bontango/SternFA/bin/changelog.txt

--	V x.02 with adapted boot_message
--	V x.03 corrections: inverted sound output (74HCT240) & internal signals, cpu clock adjusted to 833KHz
--	V x.04 added CRC check, clock speed 446KHz/892KHz, MPU200 games now in range 0..63
--
-- Everything below this line is written by scripts\release.ps1. The leading digit of
-- the version is the BOARD (1 = HW 1.0, 3 = HW 1.1 Cyclone IV, 4 = HW 1.1 Cyclone 10,
-- 5 = HW 2.0), the two sub digits are the software version from
-- rtl\common\version_pkg.vhd and move for all boards at once.

2026-09-08 15:58  version .0.5
  SW .0.5 - CPU-Takt jetzt auf ALLEN Boards 446/893 kHz. rtl\cyclone_IV\cpu_clock_gen.vhd teilte bis .0.4 haendisch 100/60 (500/833 kHz) statt 112/56; der Changelog zu x.04 nennt seit jeher 446/892 kHz, und 3,579545 MHz (Original-Stern-Quarz) / 8 bzw. / 4 ergibt 447/895 kHz - die Cyclone-10-Werte waren die richtigen, der Cyclone-IV-PLL war schlicht nie neu erzeugt worden. BETROFFEN SIND hw1_0_cyclone_IV, hw1_1_cyclone_IV UND hw2_0_dev_open; hw1_1_cyclone_10 aendert sich nicht und ist die Referenz, wie sich die anderen jetzt verhalten muessen. Beim ersten Test auf Spielgeschwindigkeit, Sound-Timing und Display-Multiplex achten - faellt etwas auf, zurueck auf SternFA_304.jic bzw. SternFA_103.jic. Ausserdem: R5101.vhd zwischen den beiden Chipfamilien vereinheitlicht (NEW_DATA_WITH_NBE_READ -> NEW_DATA_NO_NBE_READ; ohne Wirkung, width_byteena=1 und kein byteena-Port, Zahlen unveraendert), damit sich die vier Megafunction-Wrapper jetzt in nichts ausser dem Family-String unterscheiden. ERSTES RELEASE AUS DEM GEMEINSAMEN SOURCEBAUM (Umbau 08.09.2026) und ERSTES RELEASE UEBERHAUPT FUER HW 2.0 - SternFA_505.jic ist ein Prototyp-Bitstream, das Board ist nie gelaufen und FA-Control ist nie an einer Maschine gewesen. KEINE der vier Varianten ist an Hardware getestet.
  hw1_0_cyclone_IV     1.0.5    SternFA_105.jic  sha256:866FD8AB3FF3F034
  hw1_1_cyclone_10     4.0.5    SternFA_405.jic  sha256:10F4D41DD3CEE834
  hw1_1_cyclone_IV     3.0.5    SternFA_305.jic  sha256:C6C457F4412DCBF7
  hw2_0_dev_open       5.0.5    SternFA_505.jic  sha256:3359C038ADE97E95

2026-09-19 11:27  version .0.6
  SW .0.6 - nur HW 2.0: Spiel-ROM vom ESP32 statt von der SD-Karte. rtl\fa_control\esp_rom_loader.vhd fragt nach dem DIP-Lesen bis zu 3 s beim ESP32-Modul (FA-Control ab 1.21, Menue 08 GAME ROMS) nach dem gewaehlten Spiel; liegt es dort, kommen 8 KB + CRC16 ueber die UART, die SD-Karte wird nicht gelesen, Statusziffer 3. Sonst wie bisher von SD. FA-Control meldet bei Opcode 8 jetzt die volle dreistellige Spielnummer (vorher nur die Einerstelle). Fuer HW 1.0/1.1 aendert .0.6 nichts, daher kein 106/306/406. AM SCHREIBTISCH GETESTET (19.09.2026), IM AUTOMATEN NOCH NICHT. PCB v2.00 braucht weiterhin die zwei nachgeruesteten Pull-ups an GS_Dips/Opt_Dips, sonst liest sie keinen DIP. Faellt im Geraet etwas auf: zurueck auf SternFA_505.jic.
  hw2_0_dev_open       5.0.6    SternFA_506.jic  sha256:4117A4C47BCBAF2C

2026-09-19 11:48  version .0.6
  SW .0.6 (Neubau, ersetzt 506 vom 19.09. 11:27) - Options-DIP 4 und 5 auf ALLEN Boards getauscht: FA-Control-Freigabe jetzt S2-Dip4 wie bei AtariFA (passt zur Meldung "DIP 4" im Webinterface), Anti-Flicker jetzt S2-Dip5 (bis x.05 und im ersten 506 Dip4). Wer Anti-Flicker nutzt, muss den Schalter von 4 auf 5 umlegen; das Handbuch v1.04 fuer HW 1.x nennt noch Dip4. Fuer HW 1.0/1.1 ist das die einzige Aenderung gegenueber x.05 (ESP-ROM-Lader und FA-Control gibt es dort nicht), daher jetzt auch 106/306/406. HW 2.0 enthaelt ausserdem das Spiel-ROM vom ESP32 (siehe Eintrag davor). NICHT AN HARDWARE GETESTET: der erste 506 lief am Schreibtisch, dieser Neubau und 106/306/406 noch nirgends.
  hw1_0_cyclone_IV     1.0.6    SternFA_106.jic  sha256:446F5D2932F8A92A
  hw1_1_cyclone_10     4.0.6    SternFA_406.jic  sha256:41B7BEAB0BF2935B
  hw1_1_cyclone_IV     3.0.6    SternFA_306.jic  sha256:1E41E2DE371F3E9A
  hw2_0_dev_open       5.0.6    SternFA_506.jic  sha256:2364A1B9E2EE2FD6

2026-10-22 11:06  version .3.0
  SW .3.0 (x.30, nach BallyFA/WillFA7) - Spiel-ROMs aus dem Konfigurationsflash (EPCS16), wenn keine SD-Karte antwortet (SD_Card v2.1 o_no_card; ein CRC-Fehler bleibt ein Kartenfehler). rtl\common\Flash_ROM.vhd liest dasselbe Spiel unter derselben Nummer: Verzeichnis 256 x 4 Blocknummern ab 080000h, dahinter jeder 2-KByte-Chip nur einmal - so passen alle 204 Spiele der Karte v098 (Slots 0..237) in 299 Bloecke/598 KByte. Statusziffer 4 = ROM aus dem Flash, 8 = Spiel nicht im Flash (SD-LED blinkt 8x). Diese Release-Dateien enthalten KEINE Spiele (Urheberrecht) - ohne Karte also Fehler 8; die ROM-Fassung *_roms.jic entsteht lokal mit release.ps1/build.ps1 -RomImage. Flash-Pins 12/8/6/13 als User-I/O, HW 1.0 und Cyclone 10 damit bei 100 % Pins. HW 2.0 NICHT in x.30: PIN_11 (ESP32-RX) neben DCLK laesst sich nicht platzieren (Error 169182), bleibt 5.0.6. NICHT AN HARDWARE GETESTET, weder der Flash-Rueckfall noch der normale SD-Start mit dieser Version.
  hw1_0_cyclone_IV     1.3.0    SternFA_130.jic  sha256:3E606476B0D753DE
  hw1_1_cyclone_10     4.3.0    SternFA_430.jic  sha256:E782A13AF0627F48
  hw1_1_cyclone_IV     3.3.0    SternFA_330.jic  sha256:170C57018A9640DD

2026-10-22 11:53  version .3.0
  SW 5.3.0 (x.30) fuer HW 2.0 - Spiel-ROMs aus dem Konfigurationsflash wie 130/330/430 (siehe dort), Reihenfolge ESP32 -> SD -> Flash. NEUE PINBELEGUNG = PCB v2.02: ESP32_ser_rx PIN_11 -> PIN_119, SB_IRQ PIN_119 -> PIN_11. Grund: neben DCLK (PIN_12, jetzt User-I/O fuer den Flash) darf kein Ausgang liegen (Error 169182); SB_IRQ wird nirgends gelesen, PIN_10 ist auf dem dev_open-Board am CH340E. EIN UNVERAENDERTES v2.00/v2.01 VERLIERT MIT 530 DAS ESP32 (FA-Control, ROM vom ESP) - Umbau siehe target\mods_to_v200.txt Punkt 2, sonst bei SternFA_506.jic bleiben. NICHT AN HARDWARE GETESTET.
  hw2_0_dev_open       5.3.0    SternFA_530.jic  sha256:8F6D1EF290A5D86E

2026-10-30 12:40  version .3.2
  SW .3.2 - nur HW 2.0, braucht FA-Control ab 1.26 fuer die Schalter-Simulation (.3.1 wurde nie released). FA-Control-Monitor (Opcode 0x6E): Lampen, Spulen, Schalter und Displays des laufenden Spiels ohne Uebernahme lesbar, aus den PIA-Pins zurueckdekodiert. Schalter simulieren (Opcode 111): im Monitor-Modus lassen sich Schalter fuer das laufende Spiel schliessen, nur mit Options-DIP 4 auf ON; frei unter FA-Control oder nach 2 s ohne Abfrage. Korrektur: im Connect-Modus erschienen alle Schalter geschlossen, weil der Schalterscan die DIP-Baenke S1..S4 mitstrobte. Fuer HW 1.0/1.1 aendert sich nichts, daher kein 132/332/432. AM GERAET GETESTET (30.10.2026, nur am umgebauten Prototyp): Schalter in Connect- und Monitor-Modus, Schalter-Simulation, Monitor beim Seitenaufruf, Neustart der Maschine bei offener Seite, Connect. Lampen, Spulen und Displays im Monitor sind nicht einzeln bestaetigt. Faellt etwas auf: zurueck auf SternFA_530.jic.
  hw2_0_dev_open       5.3.2    SternFA_532.jic  sha256:CBB87EF4143BCD12
