bontango/SternFA/docs/SternFA_100_Final_SCH.PDF

15

14

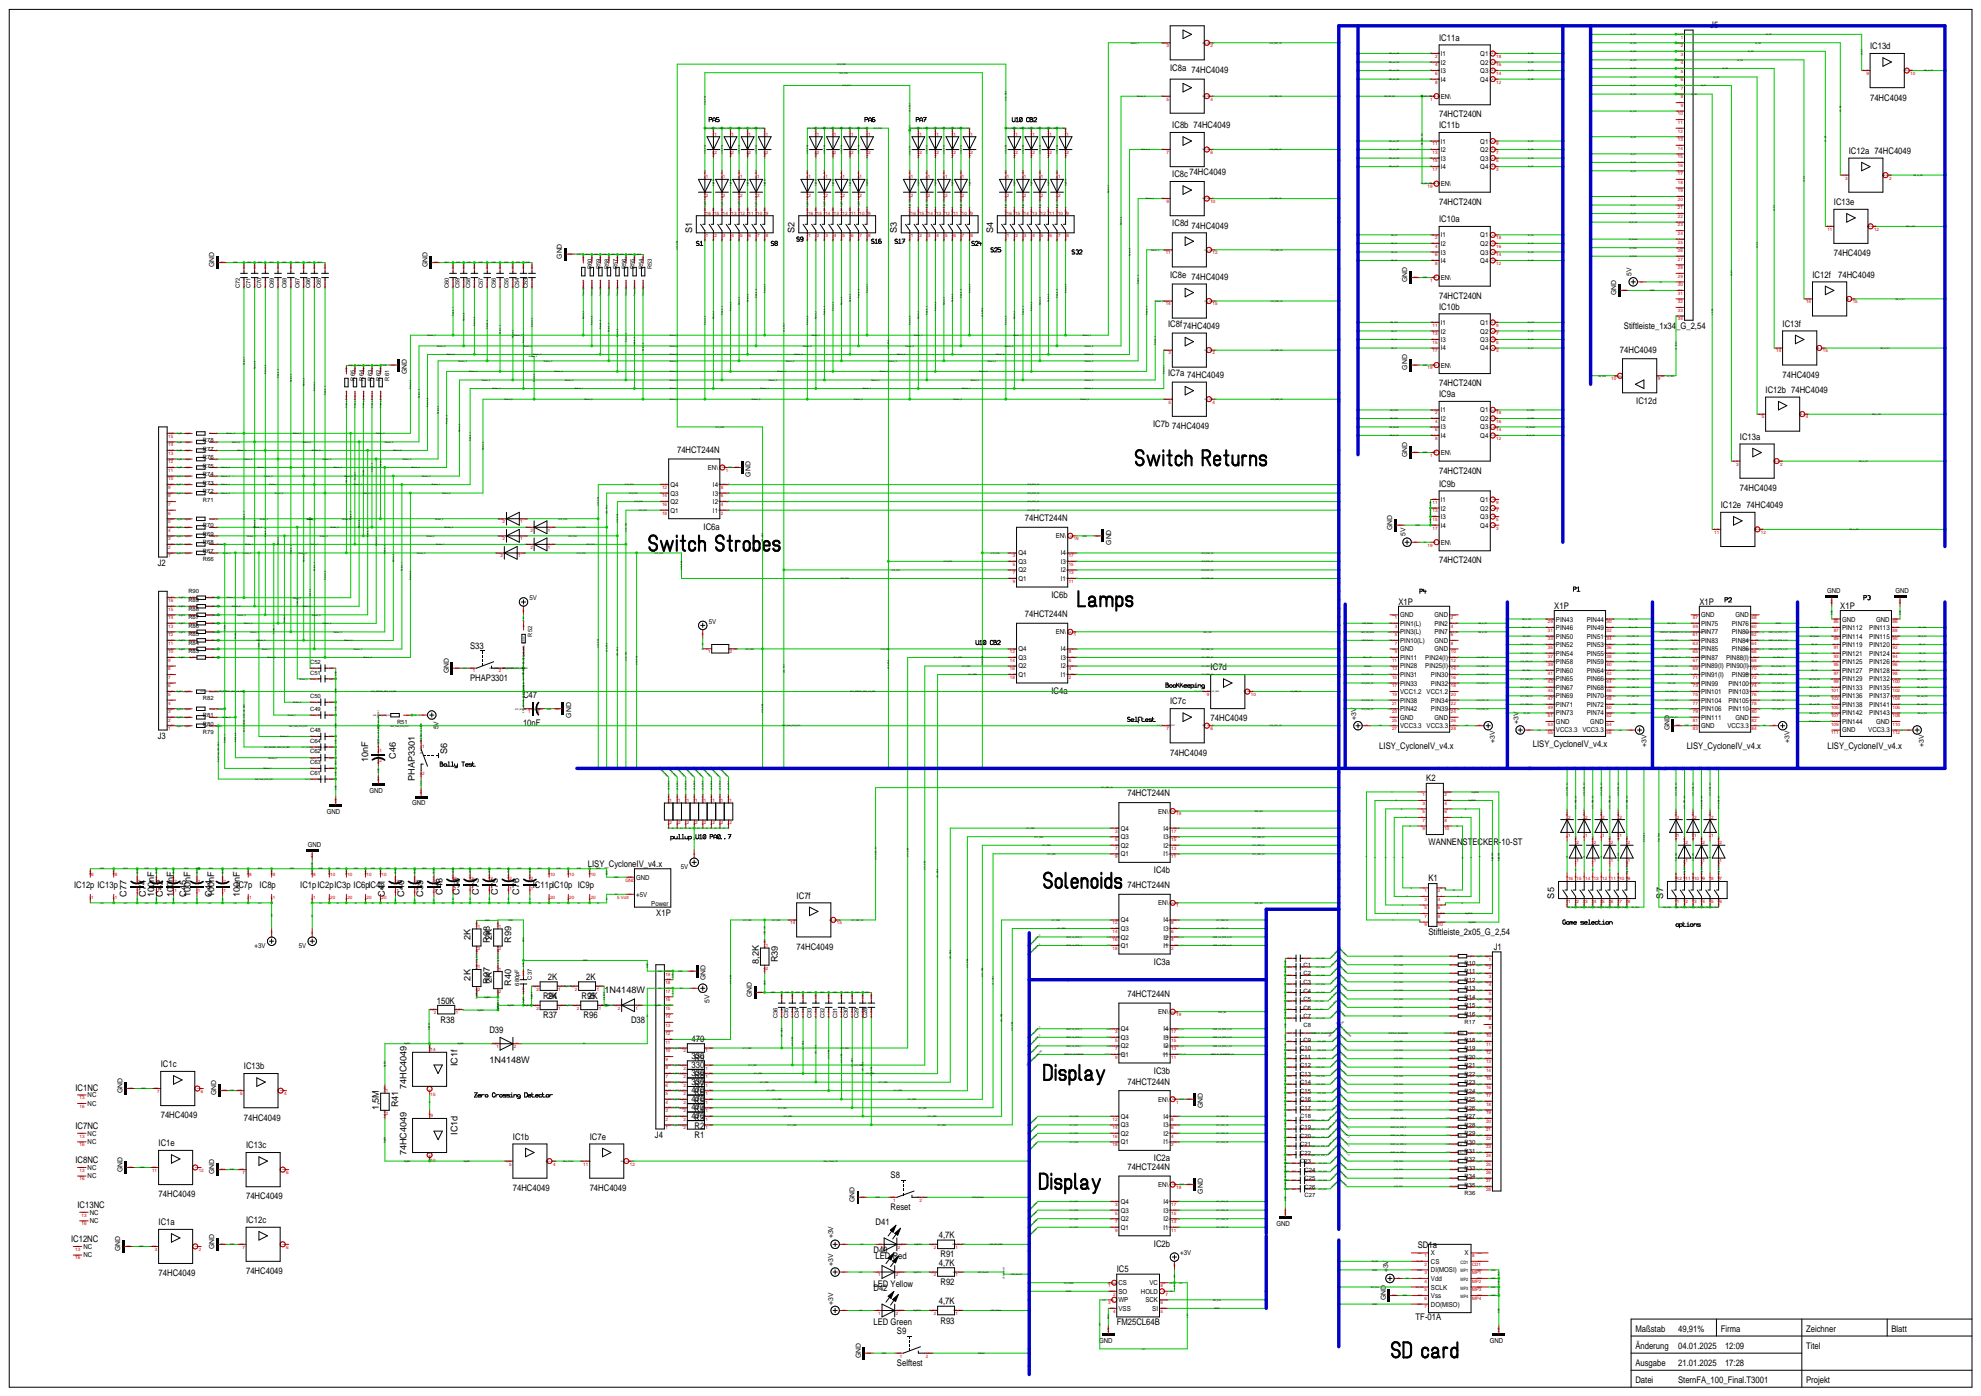
[picture p1: page 1]

GND GND GND GND

GND GND GND GND GND GND GND

GND GND GND GND GND GND GND GND GND GND GND GND GND GND GND GND GND
