bontango/SternFA/docs/SternFA_110_SCH.PDF

15

14

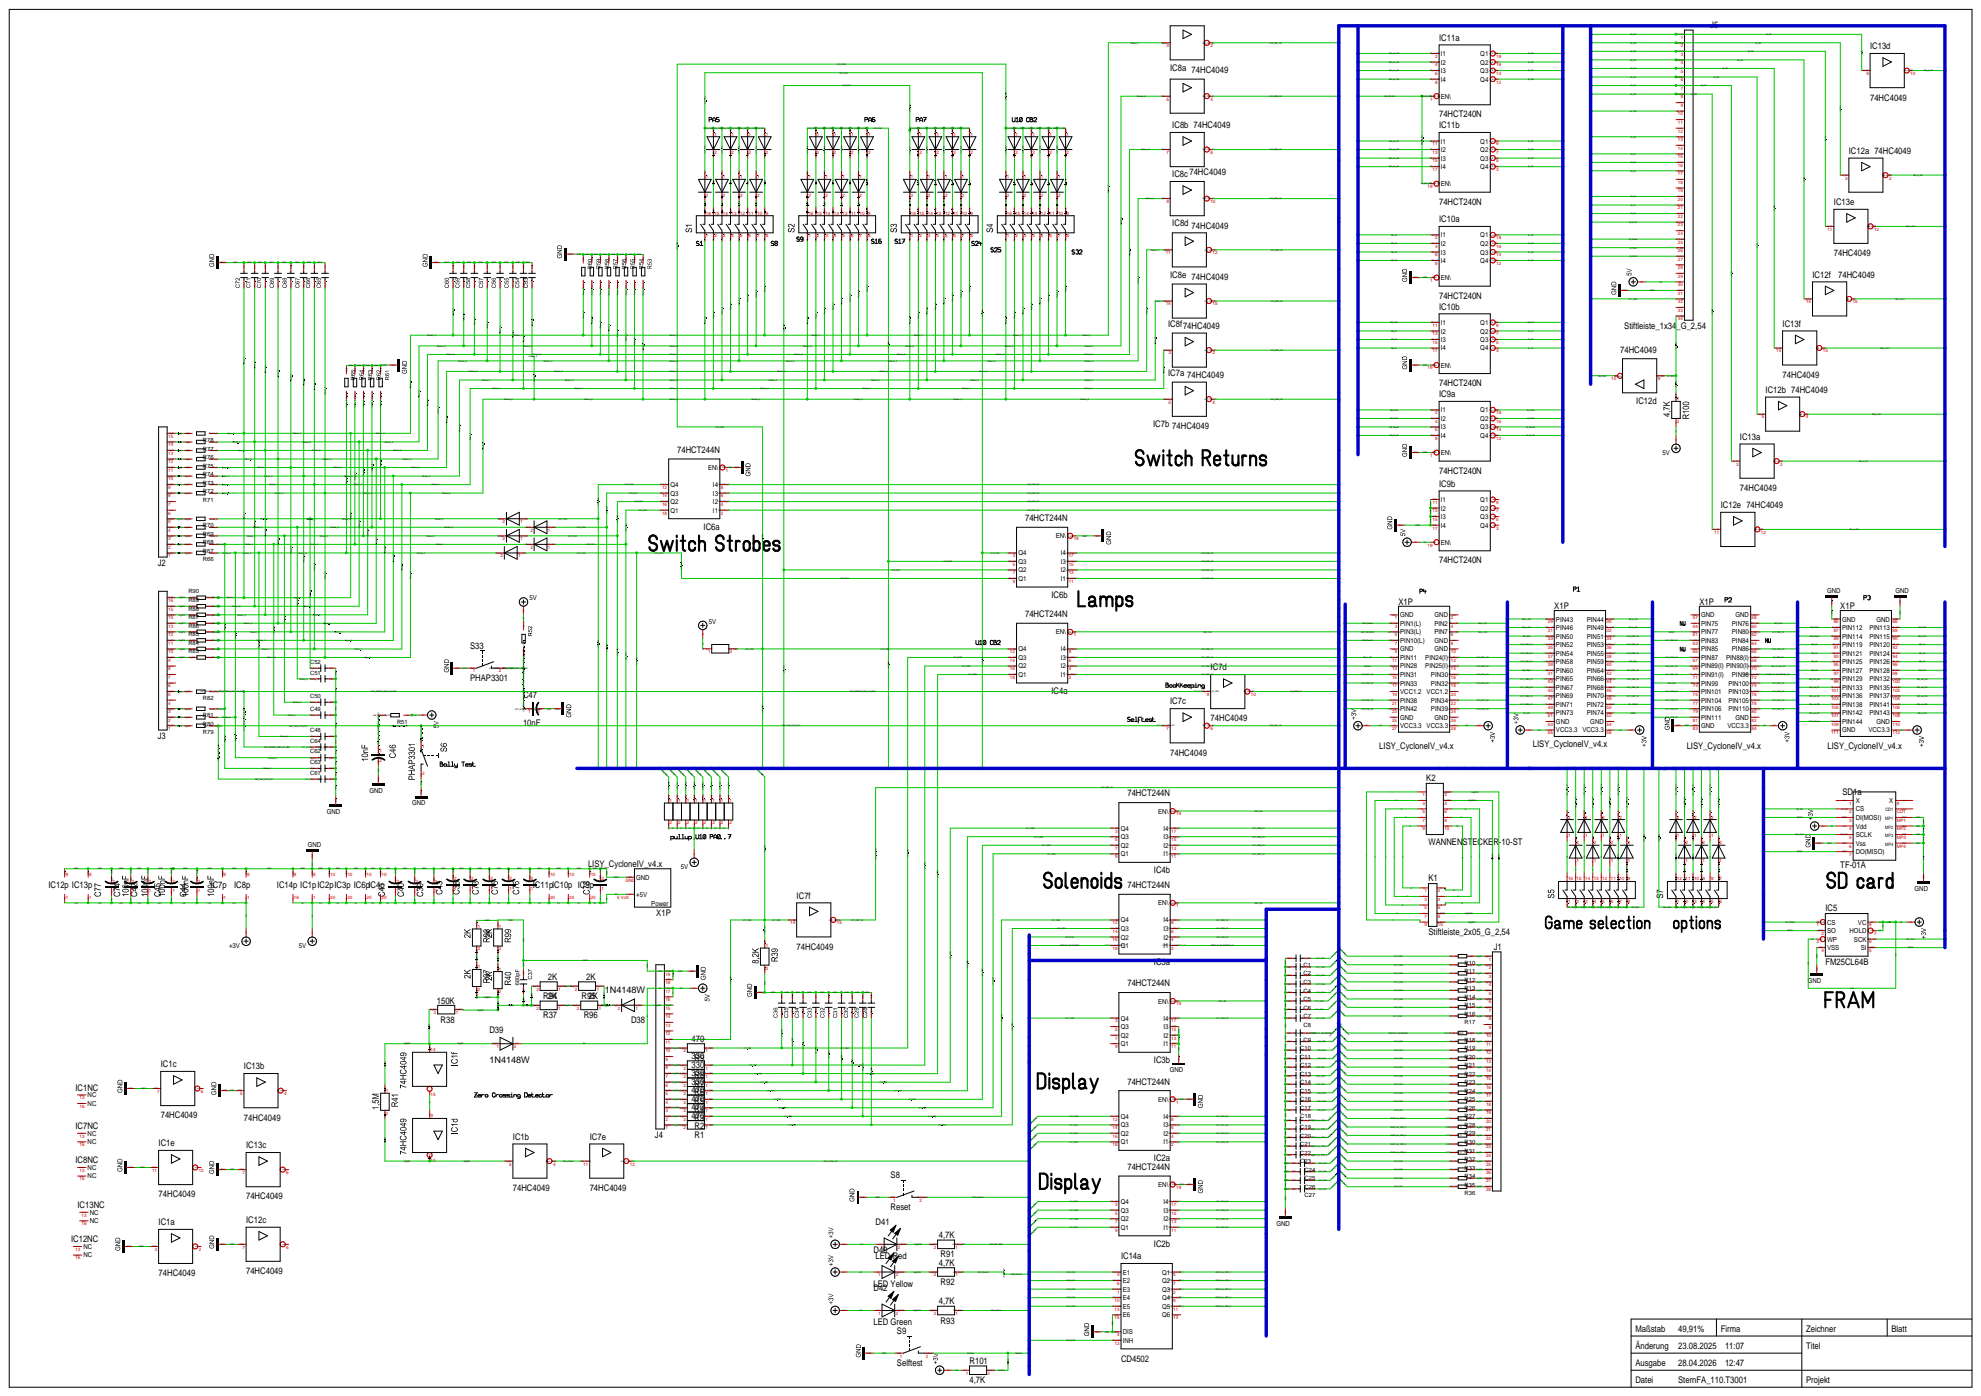
[picture p2: page 1]

Maßstab 49,91% | Firma | Zeichner | Blatt
Änderung 23.08.2025 11:07 | | Titel
