bontango/SternFA/docs/SternFA_200_Final_SCH.PDF

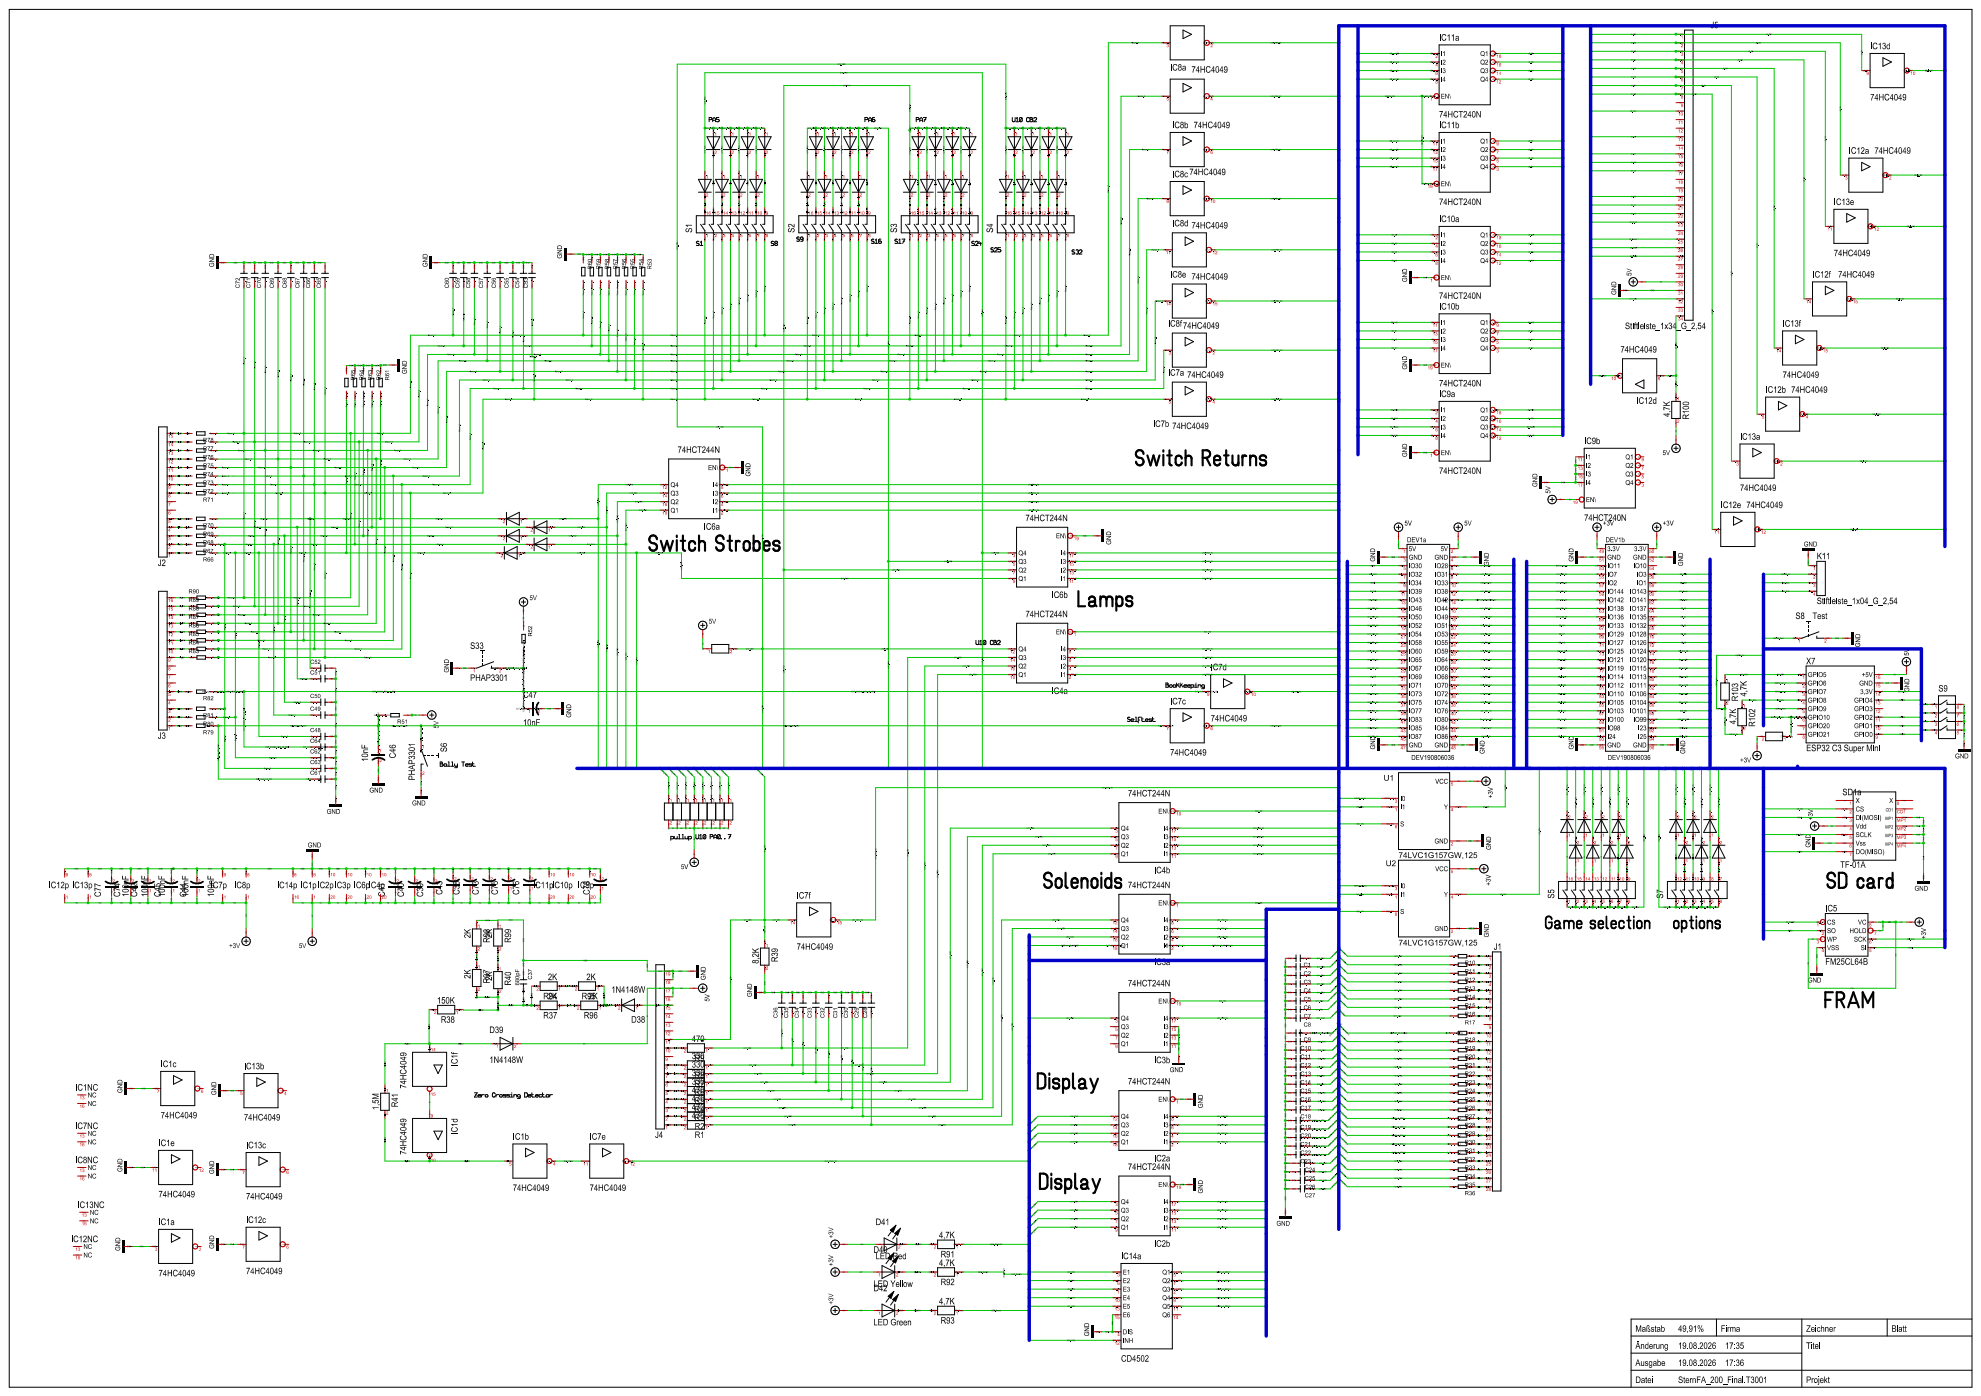
[picture p3: page 1]
