bontango/SternFA/top/SternFA.vhd

-- 'SternFA' a Stern MPU on a low cost FPGA, based on BallyFA
-- Ralf Thelen 'bontango' 01.2025
-- www.lisy.dev
--
-- ---------------------------------------------------------------------------
-- ONE top level for every SternFA board. There is no board specific copy of this
-- file any more - see ../README.md. What a board is differs in exactly three places:
--
--   variants/<name>/pins.tcl        the pin locations
--   variants/<name>/variant.psd1    which ports this board does NOT have
--                                   (VIRTUAL_PIN) and which rtl/<family>/ it uses
--   variants/<name>/variant_pkg.vhd BOARD_ID, HAS_DISP_LA_STR, HAS_ESP32
--
-- The version on the boot info display is BOARD_ID.SW_SUB1.SW_SUB2; the two sub
-- digits are in rtl/common/version_pkg.vhd and are bumped there for all boards at
-- once. BOARD_ID is historic and kept so boards in the field keep their leading
-- digit: 1 = HW 1.0 Cyclone IV, 3 = HW 1.1 Cyclone IV, 4 = HW 1.1 Cyclone 10,
-- 5 = HW 2.0 dev_open. 2 was never used, and 4.04 was already taken by the
-- Cyclone 10 board when HW 2.0 appeared - hence 5.xx rather than 4.xx.
--
-- HAS_DISP_LA_STR - PCB v1.00 only
--   v1.00 generates the five display latch strobes inside the FPGA and brings them
--   out on DISP_LA_STR. From v1.10 on an external CD4502 does that, its inhibit is
--   U10_CA2 and U11_PA(0) carries the fifth strobe. Both ports exist in this port
--   list at all times; the board that does not have them gets VIRTUAL_PIN.
--
-- HAS_ESP32 - PCB v2.00 only
--   Socket X7 for an ESP32-C3 Super Mini running FA-Control
--   (https://github.com/bontango/FA_Control), plus the two 74LVC1G157 multiplexers
--   U1/U2 that hand the two DIP return lines over to it once SOL_EN goes low. That
--   is why SOL_EN follows boot_phase(1) there and boot_phase(0) elsewhere: SOL_EN
--   is the mux select on that board as well as the solenoid buffer enable.
--
-- What changed with PCB v2.00 besides the ESP32 socket:
--   S8 Reset moved to the on-board SW2, S9 Selftest to SW3, pull-up R101 dropped.
--   SB_IRQ/ is still routed on the board and still read nowhere - SB_in_IRQ is not
--   part of cpu_irq, exactly as on the older boards. PCB v2.02 swaps it with
--   ESP32_ser_rx: SB_IRQ/ on FPGA pin 11 (was 119), ESP32_ser_rx on pin 119 (was 11),
--   because an output next to DCLK keeps the configuration flash from being used
--   (see below and variants/hw2_0_dev_open/pins.tcl).
--
-- Configuration flash as second source of the game ROMs - x.30, every board
--   The FPGA boards carry an EPCS16 on the dedicated configuration pins
--   (DCLK, nCSO, ASDO, DATA0), released as regular I/O after configuration. HW 2.x
--   only from PCB v2.02 on (or a v2.00/v2.01 rewired the same way): before, the
--   ESP32_ser_rx output sat on pin 11 next to DCLK, and Quartus does not place DCLK as
--   user I/O beside an output (Error 169182). When no
--   SD card answers (SD_Card o_no_card) rtl/common/Flash_ROM.vhd loads the selected
--   game from there: a directory plus every 2 KByte ROM chip only once, written by
--   scripts/make_flash_hex.ps1 into a local *_roms.jic. The released .jic carries no
--   ROMs; with it a boot without card ends in error 8. Status digit 4 = ROM from the
--   flash, 8 = flash slot empty.
--
-- Pin assignment of every board: variants/<name>/pins.tcl, derived from
--   docs/SternFA_110_SCH.PDF and docs/SternFA_200_Final_SCH.PDF (blocks DEV1a/DEV1b)
-- ---------------------------------------------------------------------------

library ieee;
use ieee.std_logic_1164.all;
use IEEE.numeric_std.all;
use work.instruction_buffer_type.all;	-- DISPLAY_T, rtl/common/display_pkg.vhd
use work.version_pkg.all;		-- SW_SUB1, SW_SUB2, rtl/common/version_pkg.vhd
use work.variant_pkg.all;		-- BOARD_ID, HAS_*, variants/<name>/variant_pkg.vhd
use work.fa_control_pkg.all;		-- fa_nibble_array_t, rtl/fa_control/

entity SternFA is
	port(
	   -- the FPGA board
		clk_50	: in std_logic;
		reset_sw  : in std_logic; 	-- goes Low on reset(push)
		SW_Selftest : in 	std_logic;

		-- via integrated LEDs in parallel
		LED_Status 	: out STD_LOGIC;
		LED_SD_ERR 	: out STD_LOGIC;
		LED_ZC	   :  out 	std_logic;
		SOL_EN : out 	std_logic:= '1';	-- solenoid control, and the mux select on v2.00

		-- shared SPI FRAM & SDcard
		CS_SD : out 	std_logic;
		CS_FRAM : out 	std_logic;
		MISO : in 	std_logic;
		MOSI : out 	std_logic;
		SPI_CLK : out 	std_logic;

		-- The two DIP return lines. On PCB v1.00/v1.10 they come straight from the
		-- game select and option DIP banks. On v2.00 they are the outputs of the two
		-- 74LVC1G157 multiplexers U1/U2 and carry the DIPs only while SOL_EN = '1',
		-- that is until the end of boot phase 1; afterwards U1 carries the ESP32's TX
		-- and U2 its ctrl_req. The names are kept because that is what they are during
		-- the DIP scan on every board - see the FA-Control block at the end.
		--
		-- NAMENSFALLE on v2.00: the schematic calls these two FPGA pins U1_SW / U2_SW,
		-- and the nets it calls GS_Dips / Opt_Dips are the ones on the INPUT side of
		-- U1/U2, which never reach the FPGA. Those input nets carry no pull-up of their
		-- own on PCB v2.00 - on HW 1.x the FPGA's internal one was the only one there
		-- was, and the muxes put it out of reach. Fitting it as a component is a board
		-- fix, not one that can be done here; see variants/hw2_0_dev_open/pins.tcl.
		GS_DIPS	:	in 	std_logic;
		OPT_DIPS	:	in 	std_logic;

		ZERO_CROSS	:	in 	std_logic; -- (4049 IC8)
		-- Display latch strobes. Real pins on PCB v1.00 (HAS_DISP_LA_STR), VIRTUAL_PIN
		-- on every later board, where the external CD4502 makes them from U10_PA/U11_PA.
		DISP_LA_STR	:	out 	std_logic_vector(1 to 5);
		DISP_BLANKING	:	out 	std_logic;
		             
		-- U9 NMI CPU 6800 on bally, looks like it is not working for cpu68.vhd
		S33			:	in 	std_logic; -- (4049 IC8)
		
		-- U10 PIA
		-- U10_PA, U10_CB2, U11_PA, U11_CB2 are buffer, not out: the FA-Control monitor
		-- reads back what the driver boards get (HW 2.0 only, see gen_fa_control).
		U10_PA		:	buffer 	std_logic_vector(7 downto 0):= "ZZZZZZZZ";
		U10_PB		:	in 	std_logic_vector(7 downto 0):= "ZZZZZZZZ"; --(4049 IC7 & IC8)
		U10_CA1		:	in 	std_logic; -- (4049 IC8)
		-- Inhibit of the external CD4502 from PCB v1.10 on. VIRTUAL_PIN on v1.00,
		-- where the strobes are made inside the FPGA - but still driven, and still
		-- read by DISP_BLANKING, so the behaviour is the same on both.
		U10_CA2		:	buffer 	std_logic; --display logic internal
		U10_CB2		:	buffer 	std_logic:= 'Z';
		
		-- U11 PIA
		U11_PA		:	buffer 	std_logic_vector(7 downto 0):= "ZZZZZZZZ"; 
		U11_PB		:	buffer 	std_logic_vector(7 downto 0):= "ZZZZ1111";
		U11_CA2		:	out 	std_logic:= 'Z';
		U11_CB1		:	in 	std_logic;		-- (4049 IC8)
		U11_CB2		:	buffer 	std_logic:= '1';
		
		-- J5 Stern Soundboard
		SB_out_D	:	out 	std_logic_vector(7 downto 0);
		SB_in_D	:	in 	std_logic_vector(7 downto 0);
		SB_IRQ	:	in 	std_logic;
		SB_PHI2	:	out 	std_logic;
		SB_VMA	:	out 	std_logic;
		SB_Reset	:	out 	std_logic;
		SB_RW	:		out 	std_logic;
		SB_RW_E	:	out 	std_logic;
		SB_A0	:	out 	std_logic;
		SB_A1	:	out 	std_logic;
		SB_A2	:	out 	std_logic;
		SB_A5	:	out 	std_logic;
		SB_A6	:	out 	std_logic;
		SB_A7	:	out 	std_logic;
		SB_A9	:	out 	std_logic;
		SB_A12	:	out 	std_logic;

		-- ESP32-C3 interface, PCB v2.00 only (HAS_ESP32); VIRTUAL_PIN elsewhere.
		--
		-- Names are from the ESP32's point of view: its TX reaches this FPGA as an
		-- input, its RX is driven from here. Schematic docs/SternFA_200_Final_SCH.PDF,
		-- X7:
		--   GPIO6  = net ESP32_RX     <- ESP32_ser_rx, direct, one pin
		--   GPIO7  = net ESP32_TX     -> through multiplexer U1, arrives as GS_DIPS
		--   GPIO10 = net ESP32_IO10   -> through multiplexer U2, arrives as OPT_DIPS
		--            this is ctrl_req, "I would like to take over". ACTIVE LOW and
		--            driven push-pull by the ESP. There is deliberately NO weak
		--            pull-up in the FPGA on GS_DIPS/OPT_DIPS on v2.00 - the mux
		--            outputs drive them actively; see variants/hw2_0_dev_open/pins.tcl.
		ESP32_ser_rx	: out std_logic;

		-- configuration flash EPCS16, second source of the game ROMs (Flash_ROM.vhd).
		-- Dual purpose pins, released as regular I/O in variants/<name>/device.tcl.
		FLASH_DCLK	: out std_logic;
		FLASH_NCS	: out std_logic;
		FLASH_ASDO	: out std_logic;	-- data into the flash
		FLASH_DATA0	: in  std_logic	-- data out of the flash
		);
end;

architecture rtl of SternFA is

--internal signals via logic
signal zc_stable			:	std_logic; -- Zero cross stable intern ( we have crossing clock domains)
signal zc_delayed			:	std_logic; -- for LED anti flicker
signal zc_indicator		:	std_logic; -- Zero cross indicator for LED
signal disp_int_clock 	: std_logic; --clock for display interrupt 400 Hz
signal zc_int_clock 		: std_logic; --clock for fake zero cross 100Hz
signal U10_CB1				: std_logic; --zero cross pin on PIA
signal S33_stable			:	std_logic; 

signal cpu_clk		:  std_logic; 
signal clk_500KHz		:  std_logic; -- for Bally & Stern MPU-100
signal clk_1MHz		:  std_logic; -- for MPU-200
signal is_MPU200		:  std_logic := '0'; 
signal mpu200_dig	:  std_logic_vector(3 downto 0);

signal reset_h		: 	std_logic;
signal reset_l				:	std_logic; 

signal cpu_addr	: 	std_logic_vector(15 downto 0);
signal cpu_din		: 	std_logic_vector(7 downto 0) := x"FF";
signal cpu_dout	: 	std_logic_vector(7 downto 0);
signal cpu_rw		: 	std_logic;
signal cpu_vma		: 	std_logic;  --valid memory address
signal cpu_irq		: 	std_logic;
signal cpu_nmi		:	std_logic;

-- roms
signal rom_U1_cs		: 	std_logic;
signal rom_U2_cs		: 	std_logic;
signal rom_U5_cs		: 	std_logic;
signal rom_U6_cs		: 	std_logic;

signal rom_U1_wre		: 	std_logic;
signal rom_U2_wre		: 	std_logic;
signal rom_U5_wre		: 	std_logic;
signal rom_U6_wre		: 	std_logic;

signal rom_U1_dout				:	std_logic_vector(7 downto 0);
signal rom_U2_dout				:	std_logic_vector(7 downto 0);
signal rom_U5_dout				:	std_logic_vector(7 downto 0);
signal rom_U6_dout				:	std_logic_vector(7 downto 0);

signal rom_address			: 	std_logic_vector(10 downto 0);

signal ram_U7_dout	: 	std_logic_vector(7 downto 0);
signal ram_U7_cs		:	std_logic;

signal ram_U8_dout_a	: 	std_logic_vector(7 downto 0);
signal ram_U8_dout_b	: 	std_logic_vector(7 downto 0);
signal ram_U8_cs			:	std_logic;


-- PIA U10
signal pia_U10_dout	:	std_logic_vector(7 downto 0);
signal pia_U10_irq_a	:	std_logic;
signal pia_U10_irq_b	:	std_logic;
signal pia_U10_cs		:	std_logic;
--------------------
signal pia_U10_pa_o	: 	std_logic_vector(7 downto 0);
signal pia_U10_pb_i	:  std_logic_vector(7 downto 0);
signal pia_U10_pb_raw	:  std_logic_vector(7 downto 0);
signal fa_sim_col	:  std_logic_vector(7 downto 0);	-- simulated switches of the strobed column
signal pia_U10_ca2_o	:  std_logic;
signal pia_U10_cb2_o	:  std_logic;

-- PIA U11
signal pia_U11_dout	:	std_logic_vector(7 downto 0);
signal pia_U11_irq_a	:	std_logic;
signal pia_U11_irq_b	:	std_logic;
signal pia_U11_cs		:	std_logic;
--------------------
signal pia_U11_pa_o	: 	std_logic_vector(7 downto 0); 
signal pia_U11_pb_o	:  std_logic_vector(7 downto 0);
signal pia_U11_ca2_o :  std_logic;

-- SD card
signal address_sd_card	:  std_logic_vector(15 downto 0);
signal data_sd_card	:  std_logic_vector(7 downto 0);
signal wr_rom			:  std_logic;
signal SDcard_error		:  std_logic;
signal SDcard_MOSI	:	std_logic; 
signal SDcard_CLK		:	std_logic;
signal sd_error		:  std_logic;	-- SD_Card's error LED, active low
signal sd_no_card		:  std_logic;	-- SD_Card found no card: the flash takes over

-- configuration flash (fl_), rtl/common/Flash_ROM.vhd
signal fl_addr			:  std_logic_vector(15 downto 0);
signal fl_data			:  std_logic_vector(7 downto 0);
signal fl_wr			:  std_logic;
signal fl_cpu_start	:  std_logic;	-- ROM is in from the flash
signal fl_error		:  std_logic;	-- active low, error code 8
signal fl_empty		:  std_logic;	-- selected slot is not in the flash

-- EEprom we use 256Bytes
signal address_eeprom	:  std_logic_vector(7 downto 0);
signal data_eeprom	:  std_logic_vector(7 downto 0);
signal wr_ram			:  std_logic;
signal EEprom_MOSI	:	std_logic; 
signal EEprom_CLK		:	std_logic; 

-- dip switches
signal game_select	:  std_logic_vector(7 downto 0);
signal game_option	:  std_logic_vector(6 downto 1);
signal dip_strobe	: 	std_logic_vector(7 downto 0);
-- signals used as dip strobes at boot ( with SOL_EN = 1 )
signal U11_PB_I1	: 	std_logic_vector(1 downto 0);
signal U11_PB_I2	: 	std_logic_vector(7 downto 4);
signal U10_CB2_I	:  std_logic;
signal U11_CB2_I	:  std_logic;	

-- J5 Stern Soundboard
signal SB_in_IRQ	:  std_logic;	
signal SB_Range1	:  std_logic;	
signal SB_Range2	:  std_logic;	
signal SB_cs	:  std_logic;	

-- boot message (bm_) helper
signal bm_show				:  std_logic :='1'; -- show boot message
signal bm_latch_strobe	:  std_logic_vector(4 downto 0);
signal bm_digit_enable	:  std_logic_vector(6 downto 0);
signal bm_bcd_data		:  std_logic_vector(3 downto 0);
signal bm_blanking		: 	std_logic;
signal boot_blanking		: 	std_logic; -- to disable displays during boot of ballyFA
signal bally_led_count	 : integer range 0 to 15 := 8; 		
signal bally_led_count_vec	:  std_logic_vector(3 downto 0);

-- init & boot message helper
signal g_dig0					:  std_logic_vector(3 downto 0);
signal g_dig1					:  std_logic_vector(3 downto 0);
signal g_dig2					:  std_logic_vector(3 downto 0);
signal g_digits				:  std_logic_vector(11 downto 0);	-- the three above, for FA-Control
signal o_dig0					:  std_logic_vector(3 downto 0);
signal o_dig1					:  std_logic_vector(3 downto 0);
signal b_dig0					:  std_logic_vector(3 downto 0);
signal b_dig1					:  std_logic_vector(3 downto 0);

signal boot_phase	: 	std_logic_vector(3 downto 0) := "0000";
signal boot_phase_dig	: 	std_logic_vector(3 downto 0);

--options
signal opt_zc_emulation		: std_logic; 
signal opt_fram		 		: std_logic; 
signal opt_force_Bally 		: std_logic; 
signal opt_anti_flicker		: std_logic; 
signal opt_nvram_init		: std_logic; 

-- CRC
signal crc_dig	:  std_logic_vector(3 downto 0);
signal crc_error	: std_logic;

-- SW version. The leading digit identifies the BOARD and comes from
-- variants/<name>/variant_pkg.vhd; SW_SUB1/SW_SUB2 are the shared software version
-- from rtl/common/version_pkg.vhd. Bump a release THERE, not here.
constant SW_MAIN : std_logic_vector(3 downto 0) := BOARD_ID;

-- ---------------------------------------------------------------------------
-- FA-Control (rtl/fa_control): LISY slave for the ESP32-C3 in socket X7.
-- BUILT ONLY WHERE HAS_ESP32 IS TRUE, that is on PCB v2.00. The sources are in
-- every variant's file list all the same, because Quartus resolves entity
-- references in the NOT taken branch of an if..generate too (Error 10481); the
-- boards without the socket pay compile time and no logic.
--
-- The ESP may take over when it asks via ctrl_req AND option DIP 4 is ON. While it
-- has control the CPU is held in reset and fa_io_bally drives the PIA pins instead
-- of the game. Protocol and numbering: see rtl/fa_control/fa_control.vhd.
--
-- Sizes are cut to the machine, not chosen generously: every spare entry costs a
-- register plus its share of the address decoders inside fa_control.
-- ---------------------------------------------------------------------------
constant FA_N_LAMPS	: integer := 60;	-- AS-2518-23: 15 addresses x 4 data bits
constant FA_N_SOL	: integer := 19;	-- 1..15 momentary, 16..19 continuous
constant FA_N_SW	: integer := 40;	-- 5 strobes x 8 returns
constant FA_N_DISP	: integer := 5;		-- 0 = status/credit, 1..4 = player
constant FA_DIGITS	: integer := 6;		-- digits driven per display, see boot_message

signal fa_ctrl_active	: std_logic;
signal fa_lamp_ovr	: std_logic_vector(FA_N_LAMPS - 1 downto 0);
signal fa_sol_ovr	: std_logic_vector(FA_N_SOL - 1 downto 0);
signal fa_disp_ovr	: fa_nibble_array_t(0 to FA_N_DISP * FA_DIGITS - 1);
signal fa_sw_state	: std_logic_vector(FA_N_SW - 1 downto 0);
signal fa_display1	: DISPLAY_T;
signal fa_display2	: DISPLAY_T;
signal fa_display3	: DISPLAY_T;
signal fa_display4	: DISPLAY_T;
signal fa_status	: DISPLAY_T;
-- pin drivers of fa_io_bally, muxed against the game path further down
signal fa_u10_pa	: std_logic_vector(7 downto 0);
signal fa_u11_pa	: std_logic_vector(7 downto 0);
signal fa_u11_pb	: std_logic_vector(7 downto 0);
signal fa_u10_ca2	: std_logic;
signal fa_u10_cb2	: std_logic;
signal fa_u11_ca2	: std_logic;
signal fa_u11_cb2	: std_logic;
signal fa_blanking	: std_logic;
-- U11_PB(3 downto 2) used to come straight out of the PIA port map; with the
-- FA-Control mux in between it needs a name of its own.
signal U11_PB_I3	: std_logic_vector(3 downto 2);

-- ---------------------------------------------------------------------------
-- Game ROM from the ESP32 instead of the SD card (rtl/fa_control/esp_rom_loader.vhd).
-- HW 2.0 only, same generate as FA-Control. Right after the dip scan the loader asks
-- the ESP for the selected game; if it gets one, the ROM is written through the same
-- path the SD card uses and SD_Card stays in reset. If not ('N', no answer, bad CRC)
-- esp_rom_no releases SD_Card and the boot is exactly the one without an ESP.
-- On the other boards esp_rom_no is tied to '1' and the rest to '0'.
-- ---------------------------------------------------------------------------
signal sd_cpu_reset_l	: std_logic;	-- SD_Card's "ROM is in", one of two sources of boot_phase(2)
signal esp_rom_busy	: std_logic;	-- loader owns the UART
signal esp_rom_ok	: std_logic;	-- ROM came from the ESP
signal esp_rom_no	: std_logic;	-- no ROM from the ESP, SD card takes over
signal esp_rom_addr	: std_logic_vector(15 downto 0);
signal esp_rom_data	: std_logic_vector(7 downto 0);
signal esp_rom_wr	: std_logic;
signal esp_txd		: std_logic;	-- UART lines, switched between loader and fa_control
signal fac_txd		: std_logic;
signal fac_rxd		: std_logic;
-- the four ROM memories are written from either loader
signal rom_wr_any	: std_logic;
signal rom_wr_addr	: std_logic_vector(15 downto 0);
signal rom_wr_data	: std_logic_vector(7 downto 0);

begin
-- options -- 0 if option Dip is set 
opt_zc_emulation <= game_option(1);
opt_fram <= game_option(2);
opt_force_Bally <= not game_option(3);
-- Dip4 and Dip5 swapped in .0.6 (19.09.2026): anti flicker was Dip4 up to 5.0.6 as
-- first released. Dip4 is the FA-Control permission now, as on AtariFA - that is the
-- number the FA-Control web interface names in its message.
opt_anti_flicker <= game_option(5);
-- game_option(4) has no signal of its own: on PCB v2.00 it is the FA-Control
-- permission and is read directly at the ctrl_allow port of the FAC instance at the
-- end of this file. On the older boards it is unused.
opt_nvram_init <= game_option(6);

-- determine type of CPU all games <=63 are MPU-200 games, except we have the 'Bally force' option
--is_MPU200 <= ( not game_select(5) or not game_select(6) ) and not opt_force_Bally; 
is_MPU200 <= ( game_select(6) and game_select(7) ) and not opt_force_Bally; 

-- set cpu_clk MPU-200 runs with 1MHz
cpu_clk <= clk_1MHz when is_MPU200 = '1' else clk_500KHz;


-- LEDs
-- Green LED: steady ON while FA-Control has taken over (LEDs are active low,
-- anode at +3V through 4.7k). Otherwise the Bally diagnostic LED as before -- with
-- the CPU halted pia_U11_ca2_o would just freeze.
LED_Status <= '0' when fa_ctrl_active = '1' else not pia_U11_ca2_o; -- Bally Green LED
LED_SD_ERR <= SDcard_error;
-- after a card that did not answer the flash loader owns the LED (error 8)
SDcard_error <= fl_error when sd_no_card = '1' else sd_error;
LED_ZC <= zc_indicator; -- zero cross indicator
----------------
-- boot phases
----------------
-----------------------------------------------
-- phase 0: activated by switch on FPGA board	
-- show (own) boot message
-- read first time dip settings which sets boot phase 1
-----------------------------------------------
META1: entity work.Cross_Slow_To_Fast_Clock
port map(
   i_D => reset_sw,
	o_Q => boot_phase(0),
   i_Fast_Clk => clk_50
	); 

-- status digit of the boot message: blank = ROM from SD ok, 1 = SD card error
-- (sdcard_error is active low), 2 = SD crc error, 3 = ROM from the ESP32 (HW 2.0
-- only). While the ESP path is taken SD_Card stays in reset and reports no error
-- either; esp_rom_ok comes first all the same, so the source is always visible.
-- x.30: 4 = ROM from the configuration flash (no SD card), 8 = slot not in the flash.
crc_dig <= x"3" when esp_rom_ok = '1' else
           x"8" when fl_empty = '1' else
           x"4" when fl_cpu_start = '1' else
           x"2" when crc_error = '1' else
           x"1" when sd_error = '0' else x"F";
-- show '2' in case MPU200 is selected
mpu200_dig <= x"2" when is_MPU200 = '1' else x"F";
BM: entity work.boot_message
port map(
	clk_in		=> clk_500KHz, --cpu_clk, 	
	-- Control/Data Signals,
   show  => bm_show,    
	-- output
	latch_strobe	=> bm_latch_strobe,
	digit_enable => bm_digit_enable,
	bcd_data	=> bm_bcd_data,
	blanking	=> bm_blanking,
	-- input (display data)
	display1	=> ( x"F",x"F",x"F",x"F",SW_MAIN,SW_SUB1,SW_SUB2 ),
	display2	=> ( x"F",mpu200_dig,x"F",x"F", g_dig2, g_dig1, g_dig0),
	display3	=> ( x"F",x"0",x"5",x"0",x"9",x"6",x"3" ),
	display4	=> ( x"F",x"F",x"F",x"F",x"F",o_dig1, o_dig0),
	status_d	=> ( x"F",x"F",x"F", crc_dig, x"F", x"F", bally_led_count_vec)
	);
bally_led_count_vec <= std_logic_vector(to_unsigned(bally_led_count-4, bally_led_count_vec'length));

RDIPS: entity work.read_the_dips
port map(
	clk_in		=> clk_500KHz, --cpu_clk,
	i_Rst_L  => boot_phase(0),   
	--output 
	game_select	=> game_select,
	game_option	=> game_option,
	-- strobes
	dip_strobe => dip_strobe,
	-- input
	return1 => GS_DIPS,
	return2 => OPT_DIPS,
	-- signal when finished
	done	=> boot_phase(1) -- set to '1' when reading dips is done
);		

-- use some IOs to read dips at start
-- Three sources per pin, in this order: FA-Control (CPU halted), dip strobes
-- (boot phase 0), the game. U11_PB(3 downto 2) has no dip strobe on it.
U11_PB(1) <= fa_u11_pb(1) when fa_ctrl_active = '1' else dip_strobe(0) when boot_phase(1) = '0' else U11_PB_I1(1);
U11_PB(0) <= fa_u11_pb(0) when fa_ctrl_active = '1' else dip_strobe(1) when boot_phase(1) = '0' else U11_PB_I1(0);
U10_CB2	 <= fa_u10_cb2   when fa_ctrl_active = '1' else dip_strobe(2) when boot_phase(1) = '0' else U10_CB2_I;
U11_PB(4) <= fa_u11_pb(4) when fa_ctrl_active = '1' else dip_strobe(3) when boot_phase(1) = '0' else U11_PB_I2(4);
U11_CB2	 <= fa_u11_cb2   when fa_ctrl_active = '1' else dip_strobe(4) when boot_phase(1) = '0' else U11_CB2_I;
U11_PB(5) <= fa_u11_pb(5) when fa_ctrl_active = '1' else dip_strobe(5) when boot_phase(1) = '0' else U11_PB_I2(5);
U11_PB(7) <= fa_u11_pb(7) when fa_ctrl_active = '1' else dip_strobe(6) when boot_phase(1) = '0' else U11_PB_I2(7);
U11_PB(6) <= fa_u11_pb(6) when fa_ctrl_active = '1' else dip_strobe(7) when boot_phase(1) = '0' else U11_PB_I2(6);
U11_PB(3) <= fa_u11_pb(3) when fa_ctrl_active = '1' else U11_PB_I3(3);
U11_PB(2) <= fa_u11_pb(2) when fa_ctrl_active = '1' else U11_PB_I3(2);
-- enable solenoids & displays after dip switches read.
-- On PCB v2.00 the same signal selects the two 74LVC1G157 multiplexers, so it has to
-- wait for boot_phase(1) - the DIP scan is finished only then, and switching earlier
-- would take the DIP returns away mid-read. On the older boards nothing hangs off it
-- but the solenoid buffer, and there it has always followed boot_phase(0).
gen_solen_esp: if HAS_ESP32 generate
	SOL_EN <= not boot_phase(1);
end generate;
gen_solen_plain: if not HAS_ESP32 generate
	SOL_EN <= not boot_phase(0);
end generate;

-----------------------------------------------
-- phase 1: activated by 'read_the_dips' after first read
-- read rom data of current game from SD
------------------------------------------------

--shared SPI bus; SD card only at start of game
MOSI <= SDcard_MOSI when boot_phase(2) = '0' else EEprom_MOSI;
SPI_CLK <= SDcard_CLK when boot_phase(2) = '0' else EEprom_CLK;


----------------------
-- SD card stuff
----------------------
SD_CARD: entity work.SD_Card
port map(
	i_clk		=> clk_50, 	
	-- Control/Data Signals,
   -- first dip read finished AND the ESP32 has no ROM for us (always so on HW 1.x)
   i_Rst_L  => boot_phase(1) and esp_rom_no,
	-- PMOD SPI Interface
   o_SPI_Clk  => SDcard_CLK,
   i_SPI_MISO => MISO,
   o_SPI_MOSI => SDcard_MOSI,
   o_SPI_CS_n => CS_SD,	
	-- selection
	selection => not game_select,
	-- data
	address_sd_card => address_sd_card,
	data_sd_card => data_sd_card,
	wr_rom => wr_rom,
	-- control CPU
	cpu_reset_l => sd_cpu_reset_l,
	-- feedback
	crc_error => crc_error,
	SDcard_error => sd_error,
	o_no_card => sd_no_card
	);

----------------------
-- configuration flash, x.30: starts when SD_Card found no card, reads the same game
-- (same selection, same 8 KByte image) and writes it through the ROM write path.
-- Layout and the empty-slot check (error 8): rtl/common/Flash_ROM.vhd.
----------------------
FLASHROM: entity work.Flash_ROM
port map(
	i_Clk => clk_50,
	i_Rst_L => sd_no_card,
	o_Flash_Clk  => FLASH_DCLK,
	o_Flash_CS_n => FLASH_NCS,
	o_Flash_MOSI => FLASH_ASDO,
	i_Flash_MISO => FLASH_DATA0,
	selection => not game_select,
	address_rom => fl_addr,
	data_rom => fl_data,
	wr_rom => fl_wr,
	cpu_start => fl_cpu_start,
	Flash_error => fl_error,
	flash_empty => fl_empty
	);

-- phase 2 starts when the ROM is in, from whichever source
boot_phase(2) <= sd_cpu_reset_l or esp_rom_ok or fl_cpu_start;

	
-----------------------------------------------
-- phase 2: activated by SD card read
-- read eeprom, read/write to ram
----------------------
EEprom: entity work.EEprom
port map(
								   
	i_clk => clk_50,
	address_eeprom	=> address_eeprom,
	data_eeprom	=> data_eeprom,
	wr_ram => wr_ram,
	q_ram => ram_U8_dout_b,
	-- Control/Data Signals,
   i_Rst_L  => boot_phase(2),
	-- PMOD SPI Interface
   o_SPI_Clk  => EEprom_CLK,
   i_SPI_MISO => MISO,
   o_SPI_MOSI => EEprom_MOSI,
   o_SPI_CS_n => CS_FRAM,
	-- selection
	selection => not game_select,
	-- write trigger
	w_trigger(3) => not U10_CA1,	-- self Test switch
	w_trigger(2) => U11_PB(5), -- coin lockout
	w_trigger(1) => U11_PB(6), -- flipper disable
	w_trigger(0) => not opt_fram, -- as trigger for testing	
	-- init trigger (no read, RAM will be zero)
	i_init_Flag => opt_nvram_init, -- 0 if Dip is set 
	-- fram option
	cont_save => not opt_fram,
	-- signal to outside
	--outside => LED_1
	done	=> boot_phase(3) -- set to '1' when first read of eeprom and write to cmos is done
	);	

-----------------------------------------------
-- phase 3: activated by eeprom after first read/write
-- now williams rom take control
-- game starts here
---------------------------------------------------

-- The one central signal of the FA-Control takeover: the game CPU is held in
-- reset while the host drives the machine, otherwise the lamp refresh of the game
-- would overwrite every test lamp within milliseconds. SOL_EN stays low, so the
-- solenoid buffer remains enabled -- without it no coil could be fired.
-- Letting go restarts the game from the beginning; it cannot be resumed.
reset_l <= boot_phase(3) and not fa_ctrl_active;
reset_h <= (not reset_l);

	
-- count pulses
-- close boot message
-- disable displays
-- enable solenoids
COUNT_PULSE: process(pia_U11_ca2_o)
 begin 
    if(rising_edge(pia_U11_ca2_o)) then	  
	  --show boot message for first five blinks of test and countdown
	  if ( bally_led_count > 4) then
	    bally_led_count <= bally_led_count - 1;
		 boot_blanking <= '0';
	 -- then blank diplays	 
	 elsif ( bally_led_count > 0) then
		 bally_led_count <= bally_led_count - 1;
		 bm_show <= '0';
		 boot_blanking <= '1';		
	 -- until test finished	 
	 else 
	 	 --bm_show <= '0'; --RT test 404b
		 bally_led_count <= 0;		 
		 boot_blanking <= '0';
	  end if;
  end if;      
 end process;  
 
 
-- for game select to visiualize
CONVG: entity work.byte_to_decimal
port map(
	clk_in	=> clk_50, 	
	mybyte	=> game_select,
	dig0 => g_dig0,
	dig1 => g_dig1,
	dig2 => g_dig2
	);
-- the same three digits in one vector, for FA-Control's opcode 8 (unused without it)
g_digits <= g_dig2 & g_dig1 & g_dig0;
-- for willfa option to visiualize
CONVO: entity work.byte_to_decimal
port map(
	clk_in	=> clk_50, 	
	mybyte	=> "11" & game_option,
	dig0 => o_dig0,
	dig1 => o_dig1,
	dig2 => open
	);
-- for boot phase to visiualize
boot_phase_dig <= "0000" when boot_phase="0000" else -- phase 0
						"0001" when boot_phase="0001" else -- phase 1
						"0010" when boot_phase="0011" else -- phase 2
						"0011" when boot_phase="0111" else -- phase 3
						"0100"; -- pghase 4 , never reached
						
CONVB: entity work.byte_to_decimal
port map(
	clk_in	=> clk_50, 	
	mybyte	=> "1111" & not boot_phase_dig,
	dig0 => b_dig0,
	dig1 => b_dig1,
	dig2 => open
	); 


----------------------
-- Cross domain clock stuff
-- for zero cross and S33
----------------------	
META3: entity work.Cross_Slow_To_Fast_Clock
port map(
   i_D => not ZERO_CROSS,
	o_Q => zc_stable,
   i_Fast_Clk => clk_500KHz --cpu_clk
	);


META4: entity work.Cross_Slow_To_Fast_Clock
port map(
   i_D => not S33,
	o_Q => S33_stable,
   i_Fast_Clk => clk_500KHz -- cpu_clk
	);
	
PULSE: entity work.one_pulse_only
port map(
   sig_in => S33_stable,
	sig_out => cpu_nmi,
   clk_in => clk_500KHz, --cpu_clk,
	rst => reset_l
	);

ZC_DELAY: entity work.signal_delay
port map(
  sig_in => zc_stable,
  sig_out => zc_delayed,
  clk_in => clk_500KHz --cpu_clk
	);


----------------------
-- PIA port IO mapping
----------------------

-- Fakes for testing when S1 is ON
--U10_CB1 <= zc_int_clock when S2_DIPS(1) = '0' else zc_stable; -- Zero Cross Detector 
U10_CB1 <= zc_int_clock when opt_zc_emulation = '0' -- fake zero cross for testing on the bench
				else zc_delayed when opt_anti_flicker = '0' -- delayed zero cross (LED anti flicker)
				else zc_stable; -- Zero Cross Detector 

----------------------
-- Displays, controlled by FPGA at boot time
----------------------
-- The one block that differs between PCB v1.00 and everything later. Two
-- complementary if..generate, no else generate - this is VHDL-93.
--
-- v1.00 (HAS_DISP_LA_STR): the five latch strobes are made here and leave the FPGA
-- on DISP_LA_STR, through a strobed hex inverter whose inhibit is pia_U10_ca2_o.
-- U10_CA2 and U11_PA(0) have no pin on that board (VIRTUAL_PIN) but are driven all
-- the same, U10_CA2 because DISP_BLANKING reads it further down.
--
-- v1.10 and later: an external CD4502 makes the strobes out of U10_PA(3..0) and
-- U11_PA(0); U10_CA2 is its inhibit and DISP_LA_STR has no pin. The strobes are
-- active LOW at the pin because the CD4502 inverts - hence the 'not' on
-- bm_latch_strobe, which boot_message.vhd does not apply itself.
--
-- NOTE: the v1.00 branch has no FA-Control path on the display pins. It does not need
-- one - no v1.00 board has an ESP32 socket, HAS_ESP32 is false there and fa_ctrl_active
-- is tied to '0'. A board that ever set BOTH constants true would take control of
-- lamps, coils and switches but not of the displays; that is the one combination this
-- block does not cover, and it would have to be written first.
gen_disp_la_str: if HAS_DISP_LA_STR generate
	-- Display Digit Enable
	U11_PA(7 downto 1) <= pia_U11_pa_o(7 downto 1) when bm_show = '0' else bm_digit_enable;
	U11_PA(0) <= pia_U11_pa_o(0);
	U10_CA2 <= pia_U10_ca2_o;
	-- Latch strobes ( via strobed hex inverter, inhibit is pia_U10_ca2_o )
	DISP_LA_STR(1) <= ( not  pia_U10_ca2_o ) and (not pia_U10_pa_o(0)) when bm_show = '0' else bm_latch_strobe(0);
	DISP_LA_STR(2) <= ( not  pia_U10_ca2_o ) and (not pia_U10_pa_o(1)) when bm_show = '0' else bm_latch_strobe(1);
	DISP_LA_STR(3) <= ( not  pia_U10_ca2_o ) and (not pia_U10_pa_o(2)) when bm_show = '0' else bm_latch_strobe(2);
	DISP_LA_STR(4) <= ( not  pia_U10_ca2_o ) and (not pia_U10_pa_o(3)) when bm_show = '0' else bm_latch_strobe(3);
	DISP_LA_STR(5) <= ( not  pia_U10_ca2_o ) and (not pia_U11_pa_o(0)) when bm_show = '0' else bm_latch_strobe(4);
	-- Strobes
	U10_PA <= pia_U10_pa_o when bm_show = '0' else bm_bcd_data & pia_U10_pa_o(3 downto 0);
end generate;

gen_disp_cd4502: if not HAS_DISP_LA_STR generate
	-- Display Digit Enable
	U11_PA <= fa_u11_pa when fa_ctrl_active = '1'
			else pia_U11_pa_o  when bm_show = '0' else bm_digit_enable & not bm_latch_strobe(4);
	-- Display Segment (BCD) Data
	U10_CA2 <= fa_u10_ca2 when fa_ctrl_active = '1'
			else pia_U10_ca2_o when bm_show = '0' else '0'; -- CD4502 active during boot message
	-- Strobes
	U10_PA <= fa_u10_pa when fa_ctrl_active = '1'
			else pia_U10_pa_o when bm_show = '0' else bm_bcd_data & not bm_latch_strobe(3 downto 0);
	-- No pin on these boards, but a declared output port has to be driven.
	DISP_LA_STR <= (others => '0');
end generate;


-- Blanking
-- RTH possibly need to be adjusted: 
-- BLANKING has a 4uS delay L->H when ca2_o goes H->L
-- BLANKING goes L immidiatly when ca2_o goes H
-- show boot message,then blank displays to prevent highlighted digits during boot
DISP_BLANKING <= fa_blanking when fa_ctrl_active = '1'
					  else bm_blanking when bm_show = '1'
					  else '1' when boot_blanking = '1'					  					
					  else not U10_CA2;

----------------------
-- Solenoids & Sound
----------------------
-- xx_oe = '1' output enabled
--U11_PB(0) <= pia_U11_pb_o(0) when pia_U11_pb_oe(0) = '1'  else 'Z';
-- duirect
----------------------
-- Switches
----------------------
META2: entity work.Cross_Slow_To_Fast_Clock_Bus
port map(
   i_D => not U10_PB,
	o_Q => pia_U10_pb_raw,
   i_Fast_Clk => cpu_clk
	);
-- FA-Control can close switches for the running game; '0' on boards without it.
pia_U10_pb_i <= pia_U10_pb_raw or fa_sim_col;

----------------------
-- Lamps
----------------------
-- address and data DIRECT via U10_PA
U10_CB2_I <= pia_U10_cb2_o;  --Lampstrobe #1
U11_CA2 <= fa_u11_ca2 when fa_ctrl_active = '1' else pia_U11_ca2_o;  --Lampstrobe #2

-- IRQ signals 
cpu_irq <= pia_U10_irq_a or pia_U10_irq_b or pia_U11_irq_a or pia_U11_irq_b; -- or SB_in_IRQ;

------------------
-- address decoding 
------------------
-- -17 bally MPU use only 13 Adresslines (12 downto 0)
-- -35 Bally and Stern 100 have 15 Adresslines (14 downto 0)
-- -Stern 200 have 16 Adresslines (15 downto 0)
------------------
--
-- RAM
-- U7 Memory 6810 (128 x 8 Zero-Page) 0x0000 - 0x007F
ram_U7_cs    <= '1' when cpu_addr(15 downto 7) = "000000000" and cpu_vma='1' else '0';
-- U8 Memory 5101 (256 x 4) 0x0200 - 0x02FF, D7..D4 (Stern U13 D3...D0 )
--ram_U8_cs <= '1' when cpu_addr(15 downto 8) = "00000010" and cpu_vma='1' else '0';
ram_U8_cs <= '1' when cpu_addr(15 downto 8) = "00000010" else '0'; -- RTH Test
--ram_U8_cs <= not cpu_addr(12) and cpu_addr(9) and cpu_vma;

-- IO
-- PIA U10 0x0088 - 0x008B
pia_U10_cs   <= '1' when cpu_addr(15 downto 2) = "00000000100010" and cpu_vma='1' else '0';
-- PIA U10 0x0090 - 0x0093 
pia_U11_cs   <= '1' when cpu_addr(15 downto 2) = "00000000100100" and cpu_vma='1' else '0';
-- Stern SB300 Soundboard, at 0x00A0 - 0x00A7 and 0xC0 ( A4 & A3 not decoded )
SB_Range1 <= '1'  when cpu_addr(15 downto 3) = "0000000010100" and cpu_vma='1' and is_MPU200 = '1' else '0';
SB_Range2 <= '1'  when cpu_addr = x"00C0" and cpu_vma='1' and is_MPU200 = '1' else '0';
SB_CS <= SB_Range1 or SB_Range2;

------------------
-- ROMs ----------
------------------
-- moved to RAM, initial read from SD
-- one file of 8Kbyte for all bally Variants
-- upper half for old games (2KBYTE Roms) are duplicated
-- need to be mapped to MPU memory  address range
------------------


-- U2 ROM first half   		0x1000 - 0x17FF ( Stern U1 )
rom_U1_cs <= '1' when cpu_addr(15 downto 11) = "00010" and cpu_vma='1' else '0';
-- U6 ROM first half   		0x1800 - 0x1FFF ( Stern U5 )
rom_U5_cs <= '1' when cpu_addr(15 downto 11) = "00011" and cpu_vma='1' else '0';
-- U2 ROM second half  		0x5000 - 0x57FF ( Stern U2 )
rom_U2_cs <= '1' when cpu_addr(15 downto 11) = "01010" and cpu_vma='1' else '0';
-- U6 ROM second half  		0x5800 - 0x5FFF ( Stern U6 )
-- U6 Mirror (sys vectors)	0xF800 - 0xFFFF
rom_U6_cs <= '1' when ( cpu_addr(15 downto 11) = "01011" or cpu_addr(15 downto 11) = "11111" ) and cpu_vma='1' else '0';


-----------------------------------------
-- Bus control
-----------------------------------------
 cpu_din <= 
	ram_U7_dout when ram_U7_cs = '1' else
   rom_U1_dout when rom_U1_cs = '1' else
	rom_U2_dout when rom_U2_cs = '1' else
	rom_U5_dout when rom_U5_cs = '1' else
	rom_U6_dout when rom_U6_cs = '1' else
   pia_U10_dout when pia_U10_cs = '1' else
	pia_U11_dout when pia_U11_cs = '1' else	
	ram_U8_dout_a when ram_U8_cs = '1' and is_MPU200 = '1' else		
	ram_U8_dout_a(7 downto 4) & "1111" when ram_U8_cs = '1' else		
	not SB_in_D when SB_cs = '1' else		
	x"FF";

------------------
-- ROMs ----------
-- moved to RAM, initial read from SD
-- one file of 8Kbyte for all bally Variants
-- upper half for old games (2KBYTE Roms) are duplicated
-- need to be mapped to MPU memory  address range
------------------

-- address selection
-- read from SD (or the ESP32) and write to ram when rom_wr_any == 1.
-- The two loaders never run together: SD_Card is held in reset while
-- esp_rom_busy = '1'. On HW 1.x esp_rom_busy is constant '0' and this is the old path.
-- The flash loader (x.30) runs only after SD_Card has given up (sd_no_card), and
-- SD_Card does not write any more then.
rom_wr_any  <= wr_rom or esp_rom_wr or fl_wr;
rom_wr_addr <= esp_rom_addr when esp_rom_busy = '1' else
               fl_addr      when sd_no_card = '1' else address_sd_card;
rom_wr_data <= esp_rom_data when esp_rom_busy = '1' else
               fl_data      when sd_no_card = '1' else data_sd_card;

rom_address <= rom_wr_addr(10 downto 0) when rom_wr_any = '1' else
	cpu_addr(10 downto 0);


-- ( Stern U1 ) U2 ROM first half   		0x1000 - 0x17FF 
rom_U1_wre <= '1' when rom_wr_addr(15 downto 11) = "00000" and rom_wr_any = '1' else '0';
U1: entity work.rom
port map(
	address => rom_address,	
	clock => clk_50,
	data => rom_wr_data,
	wren => rom_U1_wre,
	q	=> rom_U1_dout
	);

-- ( Stern U2 ) U2 ROM second half  		0x5000 - 0x57FF ( Stern U2 )
rom_U2_wre <= '1' when rom_wr_addr(15 downto 11) = "00001" and rom_wr_any = '1' else '0';
U2: entity work.rom
port map(
	address => rom_address,	
	clock => clk_50,
	data => rom_wr_data,
	wren => rom_U2_wre,
	q	=> rom_U2_dout
	);

-- ( Stern U5 ) U6 ROM first half   		0x1800 - 0x1FFF ( Stern U5 )
rom_U5_wre <= '1' when rom_wr_addr(15 downto 11) = "00010" and rom_wr_any = '1' else '0';
U5: entity work.rom
port map(
	address => rom_address,	
	clock => clk_50,
	data => rom_wr_data,
	wren => rom_U5_wre,
	q	=> rom_U5_dout
	);

-- ( Stern U6 ) U6 ROM second half  		0x5800 - 0x5FFF ( Stern U6 )
rom_U6_wre <= '1' when rom_wr_addr(15 downto 11) = "00011" and rom_wr_any = '1' else '0';
U6: entity work.rom
port map(
	address => rom_address,	
	clock => clk_50,
	data => rom_wr_data,
	wren => rom_U6_wre,
	q	=> rom_U6_dout
	);
	

U7: entity work.M6810 -- 56810 Ram 128Byte (128*8bit)
port map(
	address	=> cpu_addr(6 DOWNTO 0),	
	clock => clk_50,
	data		=>  cpu_dout (7 DOWNTO 0),
	wren 		=> ram_U7_cs and not cpu_rw and not cpu_clk,
	q			=> ram_U7_dout
);	

------------------------
---- 5101 ram (dual port)
------------------------
U8: entity work.R5101 -- 5101 RAM 256Byte
	port map(
		address_a	=> cpu_addr(7 downto 0),
		address_b   => address_eeprom,
		clock			=> clk_50,
		data_a		=> cpu_dout, -- Bally use the upper 4 bits, Stern all 8bits with a second 5101 (U13)
		data_b		=> data_eeprom, --8bit
		wren_a 		=> ram_U8_cs and not cpu_rw and not cpu_clk,
		wren_b 		=> wr_ram,
		q_a			=> ram_U8_dout_a,
		q_b			=> ram_U8_dout_b
);

U9: entity work.cpu68
port map(
	clk => cpu_clk,
	rst => reset_h,
	rw => cpu_rw,
	vma => cpu_vma,
	address => cpu_addr,
	data_in => cpu_din,
	data_out => cpu_dout,
	hold => '0',
	halt => '0',
	irq => cpu_irq,
	--nmi => '0'
	nmi => not cpu_nmi
);

U10: entity work.PIA6821
port map(
	clk => cpu_clk,   
   rst => reset_h,     
   cs => pia_U10_cs,     
   rw => cpu_rw,    
   addr => cpu_addr(1 downto 0),     
   data_in => cpu_dout,  
	data_out => pia_U10_dout, 
	irqa => pia_U10_irq_a,   
	irqb => pia_U10_irq_b,    
	pa_i => x"FF",  			-- not used, output only  
	pa_o => pia_U10_pa_o,   -- strobes, display data 
	ca1 => not U10_CA1,			-- self Test switch
	ca2_i => '1',    			-- not used, output only  
	ca2_o => pia_U10_ca2_o, -- Display CTRL   
	pb_i => pia_U10_pb_i,   -- Switch Returns (stabilized)	
	pb_o => open,    			-- not used, input only  
	cb1 => U10_CB1,    		-- Zero Cross
	cb2_i => '0',  			-- not used, output only  
	cb2_o => pia_U10_cb2_o,  -- Lampstrobe#1 & DIP Strobe
	default_pb_level => '0'  -- output level when configured as input
);

U11: entity work.PIA6821
port map(
	clk => cpu_clk,   
   rst => reset_h,     
   cs => pia_U11_cs,     
   rw => cpu_rw,    
   addr => cpu_addr(1 downto 0),     
   data_in => cpu_dout,  
	data_out => pia_U11_dout, 
	irqa => pia_U11_irq_a,   
	irqb => pia_U11_irq_b,    
	pa_i => x"FF",    		-- not used, output only  
	pa_o => pia_U11_pa_o,   -- display digits, latch#5,sound E 
	ca1 => disp_int_clock,  -- input 400Hz display int gen	
	ca2_i => '1',    			-- not used, output only  
	ca2_o => pia_U11_ca2_o, -- Lamp Strobe #2, Green LED   
	pb_i => x"FF",    		-- not used, output only  
	pb_o(1 downto 0) => U11_PB_I1(1 downto 0),  	-- Solenoids	
	pb_o(3 downto 2) => U11_PB_I3,
	pb_o(7 downto 4) => U11_PB_I2(7 downto 4),
	cb1 => not U11_CB1,    		-- J5 Pin32 plus Stern Lamp Int
	cb2_i => '0',  			-- not used, output only  
	cb2_o => U11_CB2_I,   		-- Solenoid/Sound Select
	default_pb_level => '1'  -- output level when configured as input (solenoids)
);
	 
-- cpu clock
clock_gen: entity work.cpu_clock_gen
port map(   
	inclk0 => clk_50,
	c0	    => clk_500KHz,
	c1		 => clk_1MHz
);


-- display interrupt generator 400 Hz
disp_int: entity work.clk_400Hz_gen 
port map(   
	clk_in => clk_500KHz, --cpu_clk,	
	clk_out	=> disp_int_clock
);

-- fake zero cross 60Hz
zc_int: entity work.zc_clk_gen 
port map(   
	dclk_in => clk_500KHz, --cpu_clk,
	dclk_out	=> zc_int_clock
);

-- zero cross indicator
-- uses display clock to scan zero cross
-- will set indicator to high if two edges or more missing
-- will set back to low if czeo cross is restored
zc_indi: entity work.zc_indicator 
port map(   
	scan_clock => clk_500KHz, --cpu_clk,
	zc_in => U10_CB1, --either from zc or from internal fake
	zc_flag	=> zc_indicator
);


-- J5 Stern Soundboard, negated output because of 74HCT240 on board
SB_out_D	<= not cpu_dout;
-- cpu_rw is high when in read mode
-- 74HCT240 is disabled with high level ( needed during read )
SB_RW_E <= cpu_rw; 
SB_in_IRQ <= SB_IRQ  when is_MPU200 = '1' else '0'; --not used at the moment
SB_PHI2	<= cpu_clk; -- used phi2' is identical to phi2 which is phi1 reverse
SB_VMA <= not cpu_vma;
SB_Reset	<= reset_h;
SB_RW	<= not cpu_rw;		
SB_A0	<= not cpu_addr(0);
SB_A1	<= not cpu_addr(1);
SB_A2	<= not cpu_addr(2);
SB_A5	<= not cpu_addr(5);
SB_A6	<= not cpu_addr(6);
SB_A7	<= not cpu_addr(7);
SB_A9	<= not cpu_addr(9);
SB_A12	<= not cpu_addr(12);


------------------------------------------------------------------------------
-- FA-Control -- LISY slave on the ESP32-C3 (rtl/fa_control/fa_control.vhd)
-- PCB v2.00 only. See the constant block above for why the sources are compiled
-- everywhere but instantiated only here.
--
-- Wiring on v2.00 (docs/SternFA_200_Final_SCH.PDF):
--   ESP32_ser_rx  -> FPGA pin 11, direct
--   ESP32's TX    -> U1 (74LVC1G157), reaches the FPGA as GS_DIPS  when SOL_EN = '0'
--   ESP32's IO10  -> U2 (74LVC1G157), reaches the FPGA as OPT_DIPS when SOL_EN = '0'
--
-- reset: deliberately not reset_l -- that one now depends on fa_ctrl_active and
-- would be a loop. It has to be boot_phase(1) anyway: before the dips are read,
-- SOL_EN = '1' and GS_DIPS/OPT_DIPS still carry the dip returns, which the UART
-- receiver would happily mistake for start bits.
--
-- ctrl_allow = not game_option(4): option DIP 4, the same number as on AtariFA
-- (it was DIP 5 until the Dip4/Dip5 swap in .0.6). Unlike AtariFA this is NOT
-- read continuously -- after boot
-- the dip lines are physically switched over to the ESP32, so the value is the one
-- latched at boot and only a reset can change it.
------------------------------------------------------------------------------
gen_fa_control: if HAS_ESP32 generate

	-- Monitor (opcode 110), byte k of the answer = mon_data(8k+7 downto 8k). The
	-- length follows from the counts FAC reports, FA-Control checks it
	-- (fa_connect_monitor_len):
	--   1      flags: bit0 CPU running (reset_l), bit1 FA control active.
	--          bit2 (attract mode) stays 0 - nothing on the pins tells.
	--          bit3 switches can be simulated (opcode 111, option DIP 4 is ON)
	--   2..9   lamps 0..59, LSB of byte 2 = lamp 0
	--   10..12 coils 1..19 now (bit0 = coil 1)
	--   13..15 coils seen since the byte was last read (cleared when sent)
	--   16     sound lines: 0. The SB-300 sits on the CPU bus, N_SOUNDS is 0.
	--   17..21 switches 0..39 (strobe * 8 + return)
	--   22..36 displays in LISY order (0 = status, 1..4 = player), 6 digits each,
	--          two BCD digits per byte, left digit in the high nibble; >= 0xA = dark
	-- SternFA has no lamp or coil matrix inside, everything leaves as raw PIA pins.
	-- So the monitor reads the pins back and decodes them the other way round from
	-- fa_io_bally - behind the muxes, i.e. game, boot message and FA control alike.
	constant FA_MON_BYTES : integer := 36;
	constant MON_WIN      : integer := 1048575;	-- lamp window, 2^20 x 20 ns = 21 ms
	type mon_nib_t  is array (0 to 4) of std_logic_vector(3 downto 0);
	type mon_disp_t is array (0 to 4) of std_logic_vector(23 downto 0);
	signal mon_data     : std_logic_vector(8 * FA_MON_BYTES + 7 downto 0);
	signal mon_rd       : std_logic;
	signal mon_idx      : integer range 0 to 255;
	-- pins, sampled twice on clk_50; a value counts when both samples agree:
	-- 26 = U11_CB2, 25 = U10_CB2, 24 = U10_CA2, 23..16 U11_PB, 15..8 U11_PA, 7..0 U10_PA
	signal mon_pin_q    : std_logic_vector(26 downto 0) := (others => '1');
	signal mon_pin_qq   : std_logic_vector(26 downto 0) := (others => '1');
	signal mon_pin      : std_logic_vector(26 downto 0) := (others => '1');
	signal mon_cb2_d    : std_logic := '1';
	signal mon_lamp_adr : std_logic_vector(3 downto 0) := "1111";
	signal mon_lamp_acc : std_logic_vector(FA_N_LAMPS - 1 downto 0) := (others => '0');
	signal mon_lamps    : std_logic_vector(FA_N_LAMPS - 1 downto 0) := (others => '0');
	signal mon_win_cnt  : integer range 0 to MON_WIN := 0;
	signal mon_sol      : std_logic_vector(23 downto 0) := (others => '0');
	signal mon_sol_x    : std_logic_vector(23 downto 0) := (others => '0');
	signal mon_sw_game  : std_logic_vector(FA_N_SW - 1 downto 0) := (others => '0');
	signal mon_sw       : std_logic_vector(FA_N_SW - 1 downto 0);
	signal fa_sim_sw    : std_logic_vector(FA_N_SW - 1 downto 0);
	signal mon_dig_d    : std_logic_vector(5 downto 0) := (others => '0');
	signal mon_latch    : mon_nib_t  := (others => x"F");
	signal mon_disp     : mon_disp_t := (others => x"FFFFFF");

begin

------------------------------------------------------------------------------
-- Game ROM from the ESP32 (rtl/fa_control/esp_rom_loader.vhd). Runs right after
-- the dip scan - the same moment U1 hands GS_DIPS over to the ESP - and before any
-- LISY session. The request names the board ("SternFA", the same string as FAC's
-- HW_NAME) and asks for 16 sectors = 8 kB, which is all SternFA uses of a game
-- slot; FA-Control keeps the roms as /roms/SternFA/<nnn>.bin. While it is busy it owns both UART lines: fa_control hears idle
-- ('1') and its txd is not on the pin. fa_control itself keeps its reset on
-- boot_phase(1), so FA-Control still connects when the SD card fails.
-- game: the SD card index is 'not game_select' (a dip that is ON reads '0'), the
-- ESP gets the very same number.
------------------------------------------------------------------------------
ESPROM: entity work.esp_rom_loader
generic map(
	CLKS_PER_BIT => 434,		-- 50 MHz / 115200 baud, like FAC
	HW_NAME      => "SternFA",	-- must match FAC's HW_NAME
	ROM_SECTORS  => 16		-- 8 kB: U1, U2, U5, U6 at 2 kB each
	)
port map(
	clk      => clk_50,
	reset    => not boot_phase(1),
	game     => not game_select,
	rxd      => GS_DIPS,		-- through U1, like FAC
	txd      => esp_txd,
	busy     => esp_rom_busy,
	rom_ok   => esp_rom_ok,
	rom_no   => esp_rom_no,
	rom_addr => esp_rom_addr,
	rom_data => esp_rom_data,
	rom_wr   => esp_rom_wr
	);

fac_rxd      <= GS_DIPS when esp_rom_busy = '0' else '1';
ESP32_ser_rx <= esp_txd when esp_rom_busy = '1' else fac_txd;


FAC: entity work.fa_control
generic map(
	CLKS_PER_BIT => 434,		-- 50 MHz / 115200 baud
	HW_NAME      => "SternFA",
	API_VER      => "0.12",
	GAME_DIGITS  => 3,		-- full game number, FA-Control files it under SternFA/<nnn>
	N_LAMPS      => FA_N_LAMPS,
	N_SOL        => FA_N_SOL,
	N_SOUNDS     => 0,		-- SB-300 sound is not driven during a takeover
	N_SW         => FA_N_SW,
	N_DISP       => FA_N_DISP,
	DISP_TYPE    => 1,		-- BCD7
	DISP_DIGITS  => (6, 6, 6, 6, 6, 0, 0),
	MAX_LAMPS    => FA_N_LAMPS,
	MAX_SOL      => FA_N_SOL,
	MAX_SW       => FA_N_SW,
	MAX_DIGITS   => FA_DIGITS,
	MON_BYTES    => FA_MON_BYTES,
	HAS_SIM_SW   => true
	)
port map(
	clk         => clk_50,
	reset       => not boot_phase(1),
	rxd         => fac_rxd,		-- ESP sends -> FPGA receives (through U1), idle while ESPROM loads
	txd         => fac_txd,		-- FPGA sends -> ESP receives, ESPROM has the pin while loading
	ctrl_req    => OPT_DIPS,	-- through U2, active low, driven by the mux
	ctrl_allow  => not game_option(4),
	ctrl_active => fa_ctrl_active,
	ver_main    => SW_MAIN,
	ver_sub1    => SW_SUB1,
	ver_sub2    => SW_SUB2,
	game_info   => g_digits,	-- game number as on the boot display, 000..255
	sw_state    => fa_sw_state,
	lamp_ovr    => fa_lamp_ovr,
	sol_ovr     => fa_sol_ovr,
	disp_ovr    => fa_disp_ovr,
	-- SternFA reports 0 sounds (see N_SOUNDS above): opcodes 50/51 are accepted
	-- without effect, the SB-300 stays on the halted CPU bus.
	snd_ovr     => open,
	snd_en      => open,
	mon_data    => mon_data,
	mon_rd      => mon_rd,
	mon_idx     => mon_idx,
	sim_sw      => fa_sim_sw
	);

------------------------------------------------------------------------------
-- The pin level part. fa_control only knows set points; on a Bally/Stern -35 the
-- decoding sits on the driver boards, so somebody has to produce the waveforms
-- the game rom would produce. That is fa_io_bally.
--
-- It runs on clk_500KHz like boot_message, while fa_control runs on clk_50. The
-- values crossing between them (set points one way, switch states the other) only
-- change at human speed, so no synchronizer is spent on them.
------------------------------------------------------------------------------
FAIO: entity work.fa_io_bally
generic map(
	N_LAMPS => FA_N_LAMPS,
	N_SOL   => FA_N_SOL,
	N_SW    => FA_N_SW
	)
port map(
	clk_in   => clk_500KHz,
	active   => fa_ctrl_active,
	display1 => fa_display1,
	display2 => fa_display2,
	display3 => fa_display3,
	display4 => fa_display4,
	status_d => fa_status,
	lamp_ovr => fa_lamp_ovr,
	sol_ovr  => fa_sol_ovr,
	pb_i     => U10_PB,
	sw_state => fa_sw_state,
	u10_pa   => fa_u10_pa,
	u11_pa   => fa_u11_pa,
	u10_ca2  => fa_u10_ca2,
	u10_cb2  => fa_u10_cb2,
	u11_ca2  => fa_u11_ca2,
	u11_pb   => fa_u11_pb,
	u11_cb2  => fa_u11_cb2,
	blanking => fa_blanking
	);

-- LISY digits arrive right aligned, most significant first: index 0 is the LEFT
-- one. The display arrays are driven at indices 1..6 by boot_message, index 1
-- being the left digit as well (that is why the boot version reads "   504"
-- right aligned) -- so this is a straight copy, no mirroring.
-- HW-TUNABLE: if the display comes out reversed on the prototype, this is the block.
fa_disp_map : process(fa_disp_ovr)
begin
	fa_display1 <= (others => x"F");
	fa_display2 <= (others => x"F");
	fa_display3 <= (others => x"F");
	fa_display4 <= (others => x"F");
	fa_status   <= (others => x"F");
	for i in 0 to FA_DIGITS - 1 loop
		fa_status(1 + i)   <= fa_disp_ovr(0 * FA_DIGITS + i);	-- LISY display 0 = status/credit
		fa_display1(1 + i) <= fa_disp_ovr(1 * FA_DIGITS + i);
		fa_display2(1 + i) <= fa_disp_ovr(2 * FA_DIGITS + i);
		fa_display3(1 + i) <= fa_disp_ovr(3 * FA_DIGITS + i);
		fa_display4(1 + i) <= fa_disp_ovr(4 * FA_DIGITS + i);
	end loop;
end process;

------------------------------------------------------------------------------
-- Monitor: the machine as it is, read without control and without touching it.
-- Pin meaning as in the head of fa_io_bally.vhd (PinMAME by35.c).
------------------------------------------------------------------------------
-- The pins change on cpu_clk, clk_500KHz or the DIP scan clock. Sample twice and
-- take a value only when both samples agree.
MON_SAMPLE: process(clk_50)
begin
	if rising_edge(clk_50) then
		mon_pin_q  <= U11_CB2 & U10_CB2 & U10_CA2 & U11_PB & U11_PA & U10_PA;
		mon_pin_qq <= mon_pin_q;
		if mon_pin_q = mon_pin_qq then
			mon_pin <= mon_pin_qq;
		end if;
	end if;
end process;

-- Lamps: the falling edge of U10_CB2 latches the address U10_PA(3..0) into the
-- 4514; the data bits U10_PA(7..4), active low, then fire lamp adr + 15 * bit.
-- Address 15 is "no lamp" - parked there while U10_PA carries display data.
-- The game only pulses each address once per zero cross, so a lamp counts as on
-- when it was fired anywhere in a 21 ms window (two half waves at 50 Hz), like
-- by35.c ORs into its lamp matrix. The second board (U11_CA2, lamps 60+) is not
-- monitored, FAC reports 60 lamps.
-- HW-TUNABLE: bit order as lamp_data in fa_io_bally.
MON_LAMP_SHADOW: process(clk_50)
	variable adr : integer range 0 to 15;
begin
	if rising_edge(clk_50) then
		mon_cb2_d <= mon_pin(25);
		if boot_phase(1) = '0' then		-- U10_CB2 is a DIP strobe until then
			mon_lamp_adr <= "1111";
		elsif mon_cb2_d = '1' and mon_pin(25) = '0' then
			mon_lamp_adr <= mon_pin(3 downto 0);
		end if;
		adr := to_integer(unsigned(mon_lamp_adr));
		if mon_win_cnt = MON_WIN then
			mon_win_cnt  <= 0;
			mon_lamps    <= mon_lamp_acc;
			mon_lamp_acc <= (others => '0');
		else
			mon_win_cnt <= mon_win_cnt + 1;
			for a in 0 to 14 loop
				if adr = a then
					for b in 0 to 3 loop
						if mon_pin(4 + b) = '0' then
							mon_lamp_acc(a + 15 * b) <= '1';
						end if;
					end loop;
				end if;
			end loop;
		end if;
	end if;
end process;

-- Coils: U11_PB(3..0) = coil 1..15 as 0..14 (15 = none) while U11_CB2 = '0'
-- selects the coil bank - with '1' the same lines are sound data. U11_PB(7..4) =
-- coils 16..19, active low. Before boot_phase(1) these pins are DIP strobes.
-- Pulses last milliseconds, the host asks every 500 ms: keep every pulse until
-- its byte has gone out. Setting wins over clearing.
MON_COILS: process(clk_50)
begin
	if rising_edge(clk_50) then
		mon_sol <= (others => '0');
		if boot_phase(1) = '1' then
			for i in 0 to 14 loop
				if mon_pin(26) = '0' and to_integer(unsigned(mon_pin(19 downto 16))) = i then
					mon_sol(i) <= '1';
				end if;
			end loop;
			for k in 0 to 3 loop
				mon_sol(15 + k) <= not mon_pin(20 + k);
			end loop;
		end if;
		for j in 0 to 2 loop
			if mon_rd = '1' and mon_idx = 13 + j then
				mon_sol_x(8 * j + 7 downto 8 * j) <= mon_sol(8 * j + 7 downto 8 * j);
			else
				mon_sol_x(8 * j + 7 downto 8 * j) <= mon_sol_x(8 * j + 7 downto 8 * j)
				                                    or mon_sol(8 * j + 7 downto 8 * j);
			end if;
		end loop;
	end if;
end process;

-- Switches: taken whenever the game reads U10 port B with one switch strobe set
-- in U10_PA(4..0). The conditions are those of by35.c pia0b_r: U10_PA(7..5) and
-- U10_CB2 set would be a DIP read. Under FA control the CPU is halted and
-- fa_io_bally scans the matrix itself (and clears its copy when it lets go).
MON_SWITCHES: process(cpu_clk)
begin
	if rising_edge(cpu_clk) then
		if pia_U10_cs = '1' and cpu_rw = '1' and cpu_addr(1 downto 0) = "10"
		   and pia_U10_pa_o(7 downto 5) = "000" and pia_U10_cb2_o = '0' then
			for s in 0 to 4 loop
				if pia_U10_pa_o(4 downto 0) = std_logic_vector(to_unsigned(2 ** s, 5)) then
					mon_sw_game(8 * s + 7 downto 8 * s) <= pia_U10_pb_i;	-- '1' = closed
				end if;
			end loop;
		end if;
	end if;
end process;

mon_sw <= fa_sw_state when fa_ctrl_active = '1' else mon_sw_game;

-- Simulated switches (opcode 111): laid over the returns of the column the game is
-- strobing, ORed in front of the PIA, so they can only close and never hide a real
-- switch. Same conditions as MON_SWITCHES - a DIP read must not see them. The monitor
-- reads pia_U10_pb_i and therefore shows them as well.
MON_SIM_COL: process(fa_sim_sw, pia_U10_pa_o, pia_U10_cb2_o)
begin
	fa_sim_col <= (others => '0');
	if pia_U10_pa_o(7 downto 5) = "000" and pia_U10_cb2_o = '0' then
		for s in 0 to 4 loop
			if pia_U10_pa_o(4 downto 0) = std_logic_vector(to_unsigned(2 ** s, 5)) then
				fa_sim_col <= fa_sim_sw(8 * s + 7 downto 8 * s);
			end if;
		end loop;
	end if;
end process;

-- Displays: while U10_CA2 = '0' the CD4502 passes the latch strobes, active low
-- at the pin: U10_PA(3..0) = player 1..4, U11_PA(0) = status. A strobed display
-- latch follows the BCD digit on U10_PA(7..4). What a digit shows is what the
-- latch holds while its enable U11_PA(2..7) (digit 1 = left .. 6) is on, so it
-- is taken when that enable goes off again - that works whether the game strobes
-- before or after switching the enable.
-- HW-TUNABLE: digit order as in fa_disp_map / fa_io_bally.
MON_DISPLAYS: process(clk_50)
begin
	if rising_edge(clk_50) then
		if mon_pin(24) = '0' then
			for k in 0 to 3 loop
				if mon_pin(k) = '0' then
					mon_latch(k + 1) <= mon_pin(7 downto 4);
				end if;
			end loop;
			if mon_pin(8) = '0' then
				mon_latch(0) <= mon_pin(7 downto 4);
			end if;
		end if;
		mon_dig_d <= mon_pin(15 downto 10);
		if mon_pin(15 downto 10) /= mon_dig_d then
			for d in 0 to 5 loop
				if mon_dig_d = std_logic_vector(to_unsigned(2 ** d, 6)) then
					for l in 0 to 4 loop
						mon_disp(l)(23 - 4 * d downto 20 - 4 * d) <= mon_latch(l);
					end loop;
				end if;
			end loop;
		end if;
	end if;
end process;

mon_data(7 downto 0)     <= x"00";		-- byte 0 is the length, sent by fa_control
mon_data(15 downto 8)    <= "0000" & (not game_option(4)) & '0' & fa_ctrl_active & reset_l;
mon_data(79 downto 16)   <= "0000" & mon_lamps;
mon_data(103 downto 80)  <= mon_sol;
mon_data(127 downto 104) <= mon_sol_x;
mon_data(135 downto 128) <= x"00";
mon_data(175 downto 136) <= mon_sw;

-- three bytes per display, the left digit pair first
mon_disp_bytes: for l in 0 to 4 generate
	mon_data(8 * (22 + 3 * l) + 23 downto 8 * (22 + 3 * l))
		<= mon_disp(l)(7 downto 0) & mon_disp(l)(15 downto 8) & mon_disp(l)(23 downto 16);
end generate;

end generate;

------------------------------------------------------------------------------
-- The boards without an ESP32 socket. fa_ctrl_active is tied to '0' here, which is
-- what lets the muxes further up (U11_PB, U10_PA/U11_PA/U10_CA2, U11_CA2, U10_CB2,
-- DISP_BLANKING, reset_l, LED_Status) stay unconditional: synthesis propagates the
-- constant and removes the whole FA-Control path. The acceptance criterion of the
-- rebuild was exactly that - the HW 1.x synthesis numbers must not move.
--
-- ESP32_ser_rx has no pin on these boards (VIRTUAL_PIN), but a declared output that
-- nobody drives is Warning 10541 and a pin Quartus places and drives anyway. '1' is
-- the idle level of an UART line.
------------------------------------------------------------------------------
gen_no_fa_control: if not HAS_ESP32 generate
	fa_ctrl_active <= '0';
	fa_sim_col     <= (others => '0');
	ESP32_ser_rx   <= '1';
	-- no ESP, no ROM from it: SD_Card starts right after the dip scan as it always did
	esp_rom_busy   <= '0';
	esp_rom_ok     <= '0';
	esp_rom_no     <= '1';
	esp_rom_addr   <= (others => '0');
	esp_rom_data   <= (others => '0');
	esp_rom_wr     <= '0';
	fa_u10_pa      <= (others => '0');
	fa_u11_pa      <= (others => '0');
	fa_u11_pb      <= (others => '0');
	fa_u10_ca2     <= '0';
	fa_u10_cb2     <= '0';
	fa_u11_ca2     <= '0';
	fa_u11_cb2     <= '0';
	fa_blanking    <= '0';
end generate;
------------------------------------------------------------------------------

end rtl;


  
