bontango/SternFA/(commit log)

2026-09-08 Bestandsaufnahme vor dem Umbau auf einen gemeinsamen Sourcebaum
    Erster Commit dieses Baums - die Historie von SternFA beginnt hier. Bis heute
    gab es kein Git; was vorher war, liegt nur als ZIP-Sicherung vor
    (C:\Users\bonta\SternFA_FPGA_source_vor_Umbau_2026-09-08.zip).
    Der Stand ist der ungeaenderte: vier vollstaendige Quartus-Projektordner
    desselben Designs, je eigene Stern.vhd / Stern.qsf / Stern.sdc, geteilte
    Module unter lib_common, lib_cyclone_IV, lib_cyclone_10 und lib_fa_control.
    SternFA_HW1.0_Cyclone_IV_v4 SW 1.03 EP4CE6E22C8
    SternFA_HW1.1_Cyclone_IV_v4 SW 3.04 EP4CE6E22C8
    SternFA_HW1.1_Cyclone_10 SW 4.04 10CL006YE144C8G
    SternFA_HW2.0_Cyclone_dev_ope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
2026-09-08 HW 1.0 auf Featurestand x.04 angeglichen - und wieder baubar gemacht
    SternFA_HW1.0_Cyclone_IV_v4 stand auf 1.03 und liess sich seit dem CRC-Umbau
    von lib_common/SD_Card.vhd (12.2025) UEBERHAUPT NICHT MEHR uebersetzen:
    Error (10481): VHDL Use Clause error at SD_Card.vhd(416): design library
    "work" does not contain primary unit "crc16_ccitt".
    Die gemeinsame SD_Card.vhd instanziiert crc16_ccitt und fuehrt address_sd_card
    als 16 Bit; die .qsf von HW 1.0 kannte die Datei nicht und das Top-Level gab
    13 Bit hinein. Der letzte erfolgreiche Build dieser Variante ist vom 07.11.2025
    (SternFA_103.jic) - genau der Schaden, gegen den der folgende Umbau antritt:
    eine Aenderung an einer geteilten Date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
2026-09-08 Etappe 1: Umzug in die Zielstruktur
    lib_common/ -> rtl/common/
    lib_fa_control/ -> rtl/fa_control/
    lib_cyclone_IV/ -> rtl/cyclone_IV/
    lib_cyclone_10/ -> rtl/cyclone_10/
    SternFA_HW1.0_Cyclone_IV_v4 -> variants/hw1_0_cyclone_IV/
    SternFA_HW1.1_Cyclone_IV_v4 -> variants/hw1_1_cyclone_IV/
    SternFA_HW1.1_Cyclone_10 -> variants/hw1_1_cyclone_10/
    SternFA_HW2.0_Cyclone_dev_open -> variants/hw2_0_dev_open/
    Das Quartus-Projektverzeichnis ist ab jetzt variants/<name>/, deshalb sind alle
    Quellpfade in den vier .qsf von ../lib_*/ auf ../../rtl/*/ umgestellt (20 bzw. 25
    je Datei). Betroffen waren nur die Dateilisten - init_file-Pfade gibt es in diesem
    Design keine, di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
2026-09-08 Etappen 2-8: ein Top-Level, generierte .qsf, Build- und Pruefskripte
    Aus vier Quartus-Projekten mit je eigener Stern.vhd wird ein Baum mit einem
    Top-Level. Je Variante bleiben sechs handgepflegte Dateien; die .qsf wird erzeugt.
    top/SternFA.vhd das eine Top-Level (Entity Stern -> SternFA)
    rtl/common/version_pkg.vhd SW_SUB1 / SW_SUB2 - die Version an EINER Stelle
    rtl/common/display_pkg.vhd instruction_buffer_type, aus boot_message.vhd geloest
    rtl/common/SternFA.sdc eine gemeinsame .sdc statt vier Kopien
    variants/<n>/variant_pkg.vhd BOARD_ID, HAS_DISP_LA_STR, HAS_ESP32
    variants/<n>/variant.psd1 Metadaten: RtlFamily, VirtualPins, BinFolder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
    [baseline.csv]
2026-09-08 README: Stand nach dem Umbau kenntlich machen
    Der Baum ist durch Synthesezahlen abgesichert, nicht durch eine Maschine. Wer
    etwas daraus baut, baut etwas Unverifiziertes - das gehoert an den Anfang der
    README und nicht in eine Fussnote.
    Claude-Session: https://claude.ai/code/session_01Jst5LMb9mhj1CFsLUi5bUh
2026-09-08 SW .0.5: CPU-Takt auf allen Boards 446/893 kHz
    Die Taktaenderung, die der Changelog seit x.04 behauptet, ist nie im Cyclone-IV-
    PLL angekommen. rtl/cyclone_IV/cpu_clock_gen.vhd teilte 100/60 (500/833 kHz),
    rtl/cyclone_10/ teilte 112/56 (446/893 kHz). Richtig sind die Cyclone-10-Werte:
    der Stern-Quarz laeuft mit 3,579545 MHz, geteilt durch 8 bzw. 4 ergibt das
    447/895 kHz. Der Wrapper wurde beim x.04-Umbau schlicht nie neu erzeugt.
    hw1_0_cyclone_IV 500/833 -> 446/893 kHz
    hw1_1_cyclone_IV 500/833 -> 446/893 kHz
    hw2_0_dev_open 500/833 -> 446/893 kHz
    hw1_1_cyclone_10 unveraendert, hatte die richtigen Werte immer schon
    Drei Varianten auf einen Schlag, weil sie sich rtl/cycl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
    [baseline.csv]
2026-09-16 HW 2.0: Kommentare zu DIP-Zuordnung und fehlenden Pull-ups
    pins.tcl erklaert die Namensfalle GS_DIPS/OPT_DIPS (Schaltplan: U1_SW/U2_SW)
    und warum PCB v2.00 zwei Pull-ups als Bauteil braucht. read_the_dips.vhd
    dokumentiert, welcher Schalter der Optionsbank in welchem Bit landet.
    Keine Logikaenderung.
2026-09-16 SW .0.6: Spiel-ROM vom ESP32 (FA-Control) statt von der SD-Karte
    Nur HW 2.0. Nach dem DIP-Lesen fragt rtl/fa_control/esp_rom_loader.vhd den
    ESP32 nach dem Spiel (A5 5A 52 <len> "SternFA" <spiel> <16>). Kommt ein ROM,
    wird es ueber denselben Pfad wie von SD_Card in die ROM-Speicher geschrieben
    und SD_Card bleibt im Reset; sonst startet SD_Card wie bisher. Statusziffer 3
    im Bootbild = ROM vom ESP. Waehrend des Ladens gehoert die UART dem Lader.
    Der Lader ist nicht SternFA-spezifisch (Generics HW_NAME, ROM_SECTORS);
    FA-Control legt die ROMs unter <HW>/<nnn> ab. Damit die Schluessel zu den
    Namensdateien passen, meldet fa_control bei Opcode 8 jetzt die volle
    Spielnummer (neuer Generic GAME_DIGIT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
    [baseline.csv]
2026-09-19 Release SW .0.6 fuer HW 2.0 (SternFA_506.jic), Handbuecher v2.06
    SternFA_506.jic ist bitgleich mit dem Build, der am Schreibtisch erfolgreich
    getestet wurde (sha256 4117A4C47BCBAF2C...). Im Automaten ist er noch nicht
    gelaufen; Rueckfall ist SternFA_505.jic.
    Nur hw2_0_dev_open: .0.6 bringt das Spiel-ROM vom ESP32 und die dreistellige
    Spielnummer fuer FA-Control, beides nur auf HW 2.0. Fuer 106/306/406 aendert
    sich nichts, deshalb sind sie nicht gebaut.
    Handbuecher v2.04 -> v2.06 (EN + DE): Software 5.06, SD-Karte nur noch ohne
    ESP-ROM noetig, Stand FA-Control "Werkbank ja, Automat nein", und neu der
    Hinweis auf die zwei fehlenden Pull-ups an GS_Dips/Opt_Dips auf PCB v2.00
    (10 kOhm nach +3V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
2026-09-19 SW .0.6: Options-DIP 4 und 5 getauscht, Release fuer alle vier Boards
    FA-Control-Freigabe jetzt S2-Dip4 (not game_option(4)) wie bei AtariFA, damit
    die Meldung "DIP 4" im FA-Control-Webinterface stimmt. Anti-Flicker wandert
    dafuer von Dip4 nach Dip5 (game_option(5)), auf allen Boards.
    Die Version bleibt .0.6: SternFA_506.jic wird ersetzt (der erste 506 vom selben
    Tag, sha256 4117A4C4..., lief am Schreibtisch), dazu kommen 106/306/406. Fuer
    HW 1.x ist der Tausch die einzige Aenderung gegenueber x.05. Synthesezahlen
    unveraendert gegenueber baseline.csv. Der Neubau ist nicht an Hardware getestet.
    Handbuecher v2.06 (EN + DE): Kapitel 4.2.4/4.2.5 und 9.1 getauscht,
    Kurzreferenz, Hinweise in 12/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
2026-10-22 SW .3.0 (x.30): Spiel-ROMs aus dem Konfigurationsflash, Release HW 1.x
    Steckt keine SD-Karte, laedt rtl/common/Flash_ROM.vhd das gewaehlte Spiel aus
    dem EPCS16 (nach BallyFA/WillFA7 x.30). SD_Card v2.1 meldet dafuer o_no_card;
    ein CRC-Fehler bleibt ein Kartenfehler.
    Stern-Karten haben 238 Slots zu 64 KByte, als 8K-Slots passt das nicht hinter
    den Bitstream. Deshalb ein Verzeichnis (256 x 4 Blocknummern ab 080000h) und
    jeder 2-KByte-Chip nur einmal: alle 204 Spiele der Karte v098 in 299 Bloecken
    (598 KByte). scripts/make_flash_hex.ps1 erzeugt das aus dem Kartenimage (nur
    Slots mit korrekter CRC, -Verify liest zurueck), build.ps1/release.ps1
    -RomImage bauen lokal *_roms.jic (gitignored, Urheb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
2026-10-22 SW 5.3.0 (x.30) fuer HW 2.0: Flash-ROMs mit Pinbelegung PCB v2.02
    Neben DCLK (PIN_12, ab x.30 User-I/O fuer den Konfigurationsflash) darf kein
    Ausgang liegen - Quartus Error 169182, minimaler Treiberstrom und LVCMOS 2 mA
    helfen nicht. Auf v2.00/v2.01 sass dort ESP32_ser_rx (PIN_11). PIN_10 ist auf
    dem dev_open-Board wie PIN_11 am CH340E (220 Ohm).
    Deshalb getauscht: ESP32_ser_rx auf PIN_119, SB_IRQ (wird nirgends gelesen)
    auf PIN_11 - ein Eingang neben DCLK ist erlaubt. Das ist die Belegung von
    PCB v2.02; ein unveraendertes v2.00/v2.01 verliert damit das ESP32 und bleibt
    bei 5.0.6 (Umbau: target\mods_to_v200.txt Punkt 2).
    Fit fehlerfrei, 90/92 Pins, Comb 5232 / Reg 2001 (+255/+135 gegen 5.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
2026-10-22 Handbuecher: Umbau v2.00 -> v2.02 fuer 5.30 beschrieben, Dateinamen ohne Version
    - SternFA_user_manual.md / SternFA_Bedienungsanleitung.md (vorher _v2.06)
    - Kopf auf Software 5.30, Dokument v1.2
    - Ladereihenfolge ESP32 -> SD -> Flash (Kap. 1, 5.3)
    - Pintausch ESP32_RX <-> SB_IRQ/ ab PCB v2.02, Umbauanleitung fuer
    v2.00/v2.01 in Kap. 13 (an einer v2.00 erprobt), Hinweise in Kap. 10/11/12/Anhang B
    - README-Verweis auf die neuen Namen
2026-10-23 Handbuecher als HTML: HW 2.0 (en/de) und neu HW 1.x, Stand x.30
    - SternFA_user_manual.html / SternFA_Bedienungsanleitung.html aus den .md (5.30),
    korrigiert: CPU-Takt 446/893 kHz (seit .0.5), HW 1.0 mit Cyclone IV v4,
    SW3 bisher ohne Funktion, Verweise auf die HTML statt .md/v1.04.pdf
    - SternFA_HW1_x_user_manual.html neu, ersetzt v1.04: Anti-Flicker Dip5,
    Dip4 ohne Funktion, Flash-Rueckfall mit Statusziffern 4/8, Boards 1xx/3xx/4xx,
    Versionsgeschichte, Spieleliste v0.98
2026-10-23 Handbuecher nur noch als HTML: .md-Fassungen entfernt, README verweist auf die HTML
2026-10-23 Handbuecher dreisprachig: HW 2.0 auf Franzoesisch, HW 1.x auf Deutsch und Franzoesisch
    Neu: SternFA_manuel_utilisateur.html, SternFA_HW1_x_Bedienungsanleitung.html, SternFA_HW1_x_manuel_utilisateur.html, aus den englischen Fassungen uebersetzt; die Spieltabelle in Anhang A ist unveraendert uebernommen. Die deutsche HW-2.0-Anleitung verweist jetzt auf die deutsche HW-1.x-Anleitung. Sprachhinweise in allen Fassungen, index.html und README mit allen sechs Handbuechern.
2026-10-23 index.html aus den Handbuechern erzeugt, Beschreibung je Handbuch
    Every manual carries <meta name=description> now; make_index.ps1 builds the landing page from the manuals in docs/ (title, language, description).
2026-10-30 SW .3.1: Monitor fuer FA-Control (Opcode 0x6E), nur HW 2.0
    fa_control.vhd transportiert den Monitor (aus GottFA1 uebernommen). Top-Level liest
    die PIA-Pins zurueck und dekodiert Lampen, Spulen, Schalter und Displays, 36 Byte.
    Dafuer U10_PA/U10_CB2/U11_PA/U11_CB2 als buffer.
    fa_io_bally: Schalterscan mit U10_PA(7:5) und U10_CB2 auf LOW. Sie stroben die
    DIP-Baenke S1..S4 auf dieselben Returns, im Connect-Modus waren dadurch alle
    Schalter "geschlossen". U10_CB2/U11_CA2 bleiben nach dem Parken auf Adresse 15 LOW.
    Comb 5741, Reg 2459, hw2 bei 97 % LE. Schalter am Geraet in beiden Modi ok; Lampen,
    Spulen und Displays im Monitor noch nicht bestaetigt. Noch kein Release.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
2026-10-30 SW .3.2: Schalter im FA-Control-Monitor simulieren, nur HW 2.0
    Opcode 111 (FA-Control ab 1.26): fa_control.vhd haelt 40 Bit, das Top-Level odert die
    gestrobte Spalte vor die PIA, nie beim DIP-Lesen. Freigabe Options-DIP 4, gemeldet als
    Bit 3 im Monitor-Flag-Byte. Frei werden sie unter FA-Control, ohne Freigabe oder nach
    2 s ohne empfangenes Byte (vorhandener wd_cnt).
    Comb 5878, Reg 2499, Fitter 6062 LE (97 %), Slack 5,53 ns. Baseline fuer hw2 nachgezogen.
